lch-98/arm6_sim2real/docs/01_design.md

# 01. 설계 기록

무엇을 왜 그렇게 정했는지 남긴다. 숫자를 바꾸고 싶을 때 어떤 조건이 같이 바뀌는지 확인하는 용도다.

## 1. 목표와 제약

- 데스크톱 크기의 6축 관절형 팔 + 평행 그리퍼
- 구조 부품은 **전부 3D 프린팅**. 구매 부품은 액추에이터, 베어링, 그리퍼 피니언 기어뿐
- 통신은 CAN, ROS 2 Humble + ros2_control
- 시뮬레이션에서 먼저 검증한 뒤 실물을 단계별로 만들고, 실물 측정값을 시뮬레이션에 되돌려 넣는다 (Sim2Real)
- 외형은 기존 제품을 따르지 않고 독자적으로 디자인한다. 관절 배치(6축 수직다관절)는 업계 공통 구성이다

## 2. 관절 구성

| 관절 | 역할 | 축 | 범위 | 원점 오프셋 |
|---|---|---|---|---|
| joint1 | 베이스 회전 | z | ±170° | 바닥에서 66 mm |
| joint2 | 어깨 피치 | y | ±110° | J1에서 z 68 mm |
| joint3 | 팔꿈치 피치 | y | −150° ~ +32° | J2에서 z 170 mm (상완) |
| joint4 | 전완 롤 | x | ±170° | J3에서 x 115 mm |
| joint5 | 손목 피치 | y | ±110° | J4에서 x 100 mm (전완) |
| joint6 | 손목 롤 | x | ±170° | J5에서 x 95 mm |
| 그리퍼 | 평행 핑거 2개 | y | 핑거당 0 ~ 20 mm | J6에서 x 56 mm |

- **홈 자세** (전 관절 0): 상완 수직, 전완~그리퍼는 앞(+x)으로 수평
- **관절 한계를 정한 근거**: 각 관절을 하나씩 돌리며 자기간섭이 처음 생기는 각도를 계산하고 여유를 둠. 관절로 바로 이어진 두 링크끼리의 간섭은 `cad/check_clearance.py`로 따로 검사 ([02](02_cad_files.md))
  - J2: 142°에서 상완이 베이스에 닿음 → ±110°
  - J3: +38°에서 전완 J4 캔이 상완 빔에 닿음 → +32°
  - J5: ±119°에서 J6 캔이 손목 요크에 닿고, −130°에서 카메라 마운트가 link3에 닿음 → ±110°
- **수평 최대 도달 거리**: J1 축에서 TCP까지 0.566 m. 전체 질량 약 2.93 kg (카메라 포함)

### 관절 구조

- **피치 관절 (J2, J3, J5)**: 양쪽 지지 요크(클레비스). 한쪽 판 바깥에 액추에이터, 반대쪽 판에 지지 베어링
  - 액추에이터 출력 → 판 구멍을 지나는 **어댑터 원판** → 자식 링크 허브
  - 반대쪽: 베어링 내륜에 **핀**이 끼워져 허브까지 들어감
  - 조립 순서: 허브를 요크 사이에 넣기 → 어댑터 삽입·체결 → 액추에이터 장착 → 베어링 압입 → 핀 삽입 → 베어링 캡
- **롤 관절 (J4, J6), 그리퍼**: 링크 끝 원통 캔에 액추에이터를 앞에서 넣고 고정 링으로 누름. 다음 링크는 출력면에 원판으로 체결
- **J1**: 베이스 기둥 안에 액추에이터가 들어감
- **그리퍼**: 모터 1개 → 모듈 1·20T 피니언 → 위·아래 랙 2개(핑거와 일체 프린팅)가 반대 방향으로 이동. 최대 벌림 약 44 mm
  - 두 랙 모두 피니언 바로 위·아래(y = 0)에 이 사이가 오도록 위상을 맞춰, 닫힌 상태에서 두 핑거가 대칭
  - **안내 구조**: 랙은 가이드판(뒤)과 앞 덮개 사이에 끼워져 y 방향으로만 미끄러진다
    - 가이드판 바깥 벽: 랙이 피니언 반대쪽(z)으로 빠지지 않게 막음
    - 앞 덮개: 랙이 앞(x)으로 빠지지 않게 막음. 랙에서 나온 스템이 덮개 슬롯을 지나 앞의 연결판·패드와 이어짐
    - 위 슬롯은 +y 끝, 아래 슬롯은 −y 끝이 열려 있어, 덮개를 먼저 체결(M3 ×6)하고 핑거를 옆에서 밀어 넣는다
    - 공차: 랙 앞뒤·벽 0.3 mm(`CLR`), 스템↔슬롯 0.4 mm(`SLOT_CLR`). 시편으로 조정
    - 스트로크 0~20 mm 전 구간에서 피니언 회전을 포함해 간섭 없음 확인
    - 슬롯이 열린 쪽에는 기계적 끝 멈춤이 없다. 스트로크는 모터 위치 한계로 제한하고, 필요하면 슬롯 끝에 멈춤 볼트를 단다
  - 핑거 안쪽 TPU 패드: 미끄럼 방지(마찰↑)와 물체 형상에 맞춰 눌리는 완충. 끝쪽 V홈은 원통형 물체를 가운데로 모음

### 외형 디자인

| 부위 | 형태 |
|---|---|
| 상완 | 속이 빈 둥근 사각 빔 (내부 = 배선 통로) |
| 요크 | 관절 쪽으로 좁아지는 윤곽, 판과 브릿지가 하나로 이어진 U자 |
| 베이스 | 팔각 플랜지 + 원뿔대 기둥, 뒤쪽 케이블 출구 |
| 그리퍼 | 원통형 하우징 + 가로 가이드판, 핑거 안쪽 V홈 |
| 배색 | 본체 웜 화이트, 캡·패드 주황 |

## 3. 통신: 일반 CAN으로 충분한가

CAN 2.0A 8바이트 프레임 = 111비트, 비트 스터핑 최악 135비트 → 1 Mbps에서 프레임당 약 0.135 ms.
모터 7개 × (명령 + 응답) = 한 주기에 14프레임.

| 제어 주기 | 버스 부하 |
|---|---|
| 100 Hz | 19% |
| 200 Hz | 38% |
| 250 Hz | 47% |
| 500 Hz | 94% |

**결론**: 200~250 Hz 제어까지 여유가 있어 CAN FD가 필요 없다. 컨트롤러 주기는 200 Hz로 정했다.
일반 CAN이면 기존 USB-CAN 어댑터를 그대로 쓸 수 있고, 리눅스 커널 버전 제약도 없다.

## 4. 액추에이터 선정

Damiao 제품군으로 통일했다. 실제 구매는 **Seeed reBot Arm B601-DM Body Motor Kit**(4340P ×3, 4310 ×3, USB-CAN 보드, 전원 분리 보드, XT30(2+2) 케이블)에 그리퍼용 H3510 1개를 더한 구성이다. 모두 드라이버 일체형이고 기본 통신이 CAN 1 Mbps이며, 같은 프로토콜(MIT·위치·속도 모드)을 쓴다.

| 관절 | 모델 | 정격 / 피크 토크 | 외경 × 높이, 질량 | 판매처 표시가 (2026-10) |
|---|---|---|---|---|
| J1, J2, J3 | DM-J4340P-2EC | 9 (판매처에 따라 12) / 27 N·m (40:1) | 57 × 56.5 mm (출력 플랜지 약 Ø38 × 1.5), 약 375 g | 키트 |
| J4, J5, J6 | DM-J4310-2EC | 3 / 7 N·m (10:1) | 57 × 46 mm (출력 플랜지 Ø35 × 1.0), 약 300 g | 키트 |
| 그리퍼 | DM-H3510 | 0.18 / 0.45 N·m (직결) | 42 × 31.5 mm, 116 g | 약 $47 (별도) |

- 치수는 판매처 도면(디바이스마트 키트 페이지), 정격·질량은 Seeed의 DAMIAO 43 시리즈 자료값. 4340P 출력 플랜지 지름은 도면에 수치가 없어 도면 축척으로 잰 값이다
- 판매처마다 정격값 표기가 다른 경우 낮은 값을 썼다. 모터를 받으면 질량을 저울로 재고 출력 플랜지를 캘리퍼스로 재서 `ACT`를 바꾼다
- **검토했다가 뺀 구성**
  - CAN FD + 어깨 DM-J8009 (20 N·m): 팔을 크게 만들 때의 구성. 소형으로 줄이면서 불필요해졌고 비용이 큼
  - DM-S2325, DM-S3519 (더 저렴): 증분형 엔코더라 전원을 켤 때마다 원점 복귀가 필요하고, 형상이 길어 관절 옆으로 튀어나옴

## 5. 크기와 토크

처음에는 Dobot Magician(리치 320 mm)급으로 줄였다가, 링크 사이 공간(공구·배선)이 부족해 상완 170 mm, 전완 100 mm로 늘렸다. 이후 J6를 4310(Ø57)으로 바꾸면서 J6 캔이 손목 요크에 닿지 않도록 손목(L5)을 70 → 95 mm로 늘렸다.
늘리면서 J3(4310)의 토크 여유가 부족해져(0.2 kg에서 정격의 91%) **J3를 4340으로 바꿨다** (이후 키트 구성으로 J1~J3 모두 4340P).

팔을 수평으로 완전히 편 최악 자세의 정적 중력 토크 (카메라·마운트 포함):

| 가반하중 | J2 (정격 9 N·m) | J3 (정격 9 N·m) | J5 (정격 3 N·m) |
|---|---|---|---|
| 0 kg | 6.1 N·m (68%) | 3.0 N·m (34%) | 0.55 N·m (18%) |
| 0.3 kg | 7.8 N·m (87%) | 4.2 N·m (46%) | 1.1 N·m (36%) |
| 0.5 kg | 8.9 N·m (99%) | 5.0 N·m (55%) | 1.4 N·m (48%) |

→ **설계 가반하중 0.3 kg** (최악 자세 기준, 가속 여유 포함). 한계는 J2이며 정격 9 N·m 기준 정적 최대는 약 0.50 kg (4340P 정격이 12 N·m면 J2 사용률 약 65%).
손목 자세를 전부 훑었을 때 J6 최대 중력 토크는 0.048 N·m (4310 정격의 2%).

**질량 가정**: 프린팅 부품은 PLA 1240 kg/m³ × 실효 충진율 0.5, 액추에이터는 사양표 질량, 베어링·볼트·배선 미포함.
실측값은 단계 2(시편 무게), 단계 3(중력 토크 식별)에서 바꾼다.

## 6. 손목 카메라 (Intel RealSense D435)

- 그리퍼 바디 위 패드(M3 인서트 2개)에 브래킷을 체결하고, 카메라 외형(90 × 25 × 25 mm)을 받침과 클램프로 잡는다
  - 카메라의 삼각대 나사·뒷면 M3 위치는 공개 자료에서 간격을 확인하지 못해 외형으로 잡는 방식을 택함
- 위치: link6 기준 카메라 본체 중심 (x 20, z 54) mm, 아래로 25° 숙임
  - TCP는 광축에서 약 14° 아래, 그리퍼 앞 200 mm 지점은 약 13° 위 → 둘 다 RGB 화각(세로 ±21°) 안
- 한계: 카메라~TCP 약 85 mm로 D435 최소 깊이 거리(0.105 m)보다 가깝다. **집는 순간 핑거 주변은 깊이값이 없고 RGB만 보인다.** 인식은 10 cm 이상 떨어진 접근 단계에서 끝내는 구성을 가정
- TF: `camera_link`(본체 중심, RealSense 드라이버와 같은 이름), `camera_optical_nominal`(공칭 광학 프레임)

## 7. 수정 이력

| 날짜 | 내용 | 이유 |
|---|---|---|
| 2026-10-27 | 6축 + 그리퍼 개념 모델, URDF·RViz | 시작 |
| 2026-10-27 | 외형 차별화 (빔·요크·베이스·그리퍼·배색) | 기존 제품과 디테일이 겹치지 않도록 |
| 2026-10-28 | 액추에이터 치수 반영, 전 부품 프린팅 구조 | 실물 제작 기준으로 전환 |
| 2026-10-28 | CAN FD → 일반 CAN, 소형화, 저가 모터 | 대역폭 계산 결과 일반 CAN으로 충분, 비용 |
| 2026-10-28 | 링크 연장, J3 4310 → 4340 | 링크 사이 공간 부족, 연장 후 J3 토크 여유 부족 |
| 2026-10-29 | 손목 D435 마운트 추가 | 이후 비전 작업 대비 |
| 2026-11-04 | 요크를 한 윤곽 돌출 + 홈 방식으로 변경 | 사다리꼴 판과 직사각 브릿지가 만나는 곳에 최대 3.5 mm 단차가 있었음 |
| 2026-11-04 | ros2_control (mock, Gazebo), 기준 궤적, 기록·분석 도구 | 시뮬레이션 기준선 ([04](04_sim_baseline.md)) |
| 2026-11-10 | 모터 구성을 키트 기준으로 변경: J1~J3 4340P, J6 4310, 그리퍼만 H3510. 베이스 높이 58 → 66 mm | Seeed reBot Arm B601-DM Body Motor Kit(4340P ×3, 4310 ×3) 구매. 단품보다 저렴하고 USB-CAN·케이블 포함. 4340P가 더 높아 베이스를 올림 |
| 2026-11-11 | 손목 L5 70 → 95 mm, J3 상한 +60° → +32°, 그리퍼 랙 가이드판 분리, 분해도 STEP·이웃 링크 간섭 검사 추가 | J6 캔(4310)이 손목 요크판·J5 모터와 겹침(FreeCAD에서 발견). 이웃 링크끼리는 URDF 충돌 검사에서 빠져 있었고, 같은 검사로 J3 +38° 간섭도 찾음. 그리퍼 모터가 캔과 판 사이에 갇혀 조립할 수 없었음 |
| 2026-11-11 | 그리퍼 랙 안내 구조 추가: 가이드판 바깥 벽 + 앞 덮개(`rack_cover`) + 핑거 스템 | 핑거를 붙잡는 구조가 없어 랙이 앞·옆으로 빠질 수 있었음 |
| 2026-11-11 | 피니언을 인벌류트 치형으로 표시, 랙 위상 정렬, 핑거 캐리지를 피니언 앞으로 우회 | 피니언이 원기둥으로만 표시되어 물림을 확인할 수 없었음. 치형으로 바꾸자 핑거 캐리지가 피니언과 겹치는 것이 드러남 |
| 2026-11-11 | 액추에이터 출력 플랜지 치수(4340P 약 Ø38×1.5, 4310 Ø35×1.0)와 4340P 질량(362 → 375 g) 반영 | 판매처 도면·Seeed 자료와 대조. 이전에는 출력부를 외경의 0.3배 × 3 mm로 가정했음 |

## 8. 남은 과제

- **액추에이터 체결 구멍**: 하우징·출력 플랜지 볼트 패턴은 공식 도면(STEP)을 받은 뒤 반영 (단계 2). 그 전에는 출력하지 않는다
- 질량·관성은 프린팅 시편과 중력 토크 식별로 실측값으로 바꾼다
- **J1 베이스 베어링 보류** (2026-11-12): J1은 팔 전체가 넘어지려는 모멘트(0.3 kg에서 최대 약 7.8 N·m)를 모터 출력 베어링이 받는다. Damiao가 허용 모멘트를 공개하지 않아 일단 베어링 없이 조립하고, 흔들림·처짐이 보이면 베이스와 link1만 바꿔 61814급 베어링을 추가한다
