lch-98/arm6_sim2real/docs/README.md

# 문서 목차

처음부터 순서대로 읽으면 같은 팔을 만들 수 있도록 정리한 문서다.
각 문서는 **왜 그렇게 정했는지 → 어떻게 하는지 → 결과가 어떻게 나와야 하는지** 순서로 쓴다.

| 순서 | 문서 | 내용 | 상태 |
|---|---|---|---|
| 00 | [로드맵](00_roadmap.md) | 전체 단계 계획 (구매 순서, 단계별 측정 항목, 소모품·공구) | 계획 |
| 01 | [설계 기록](01_design.md) | 구조·통신·모터·치수를 정한 근거, 수정 이력 | 완료 |
| 02 | [CAD와 파일](02_cad_files.md) | 형상 생성 스크립트, STEP/STL 차이, 프린팅 파일 | 완료 |
| 03 | [개발 환경](03_dev_setup.md) | Ubuntu 22.04 + ROS 2 Humble + Gazebo 설치, 빌드 | 완료 |
| 04 | [시뮬레이션 기준선](04_sim_baseline.md) | ros2_control (mock, Gazebo), 기준 궤적, 기록·분석 | 완료 |
| 05 | [모터 단품 벤치](05_motor_bench.md) | 준비물, CAN 설정, 벤치 도구(`arm_hardware`), 모터 특성 측정, 1축 하드웨어 인터페이스 | 진행 중 |
| 06 | 체결 설계·프린팅 시편 | 볼트 패턴 반영, 공차·소재 확정 | 예정 |
| 07 | J1~J3 서브 어셈블리 | 조립, 영점, 중력 토크로 질량 식별 | 예정 |
| 08 | 손목·그리퍼 | 손목 조립, 그리퍼 보정 | 예정 |
| 09 | 전체 통합 | MoveIt 실기 구동, 안전 기능, 손목 카메라 | 예정 |
| 10 | Sim2Real 루프 | 식별값 반영, 시뮬레이션 랜덤화 | 예정 |

실험 결과(분석 요약, 그래프)는 [results/](results/)에 단계별로 모은다.

## 용어

| 용어 | 뜻 |
|---|---|
| 기준선 (baseline) | 실물과 비교하기 위해 시뮬레이션에서 먼저 만들어 두는 기록 |
| 기준 궤적 세트 | 모든 단계에서 똑같이 돌리는 동작 목록 (`reference_trajectories.yaml`) |
| mock 하드웨어 | 명령을 그대로 상태로 돌려주는 가짜 하드웨어. 동역학이 없음 |
| 유지 토크 | 그 자세에서 팔이 처지지 않게 모터가 내야 하는 토크 |
| TCP | Tool Center Point. 그리퍼 끝에서 10 mm 안쪽 기준점 |
