lch-98/arm6_sim2real/arm_description/cad/arm_assembly.step

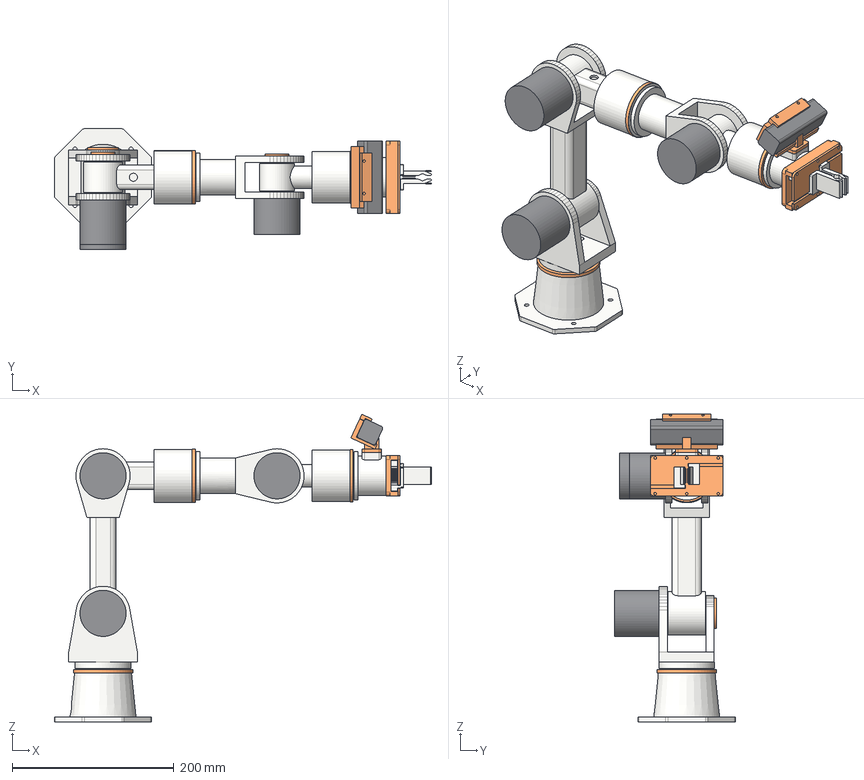
[picture p3: CAD file, 2026-11-11]
arm_description/cad/arm_assembly.step
466.0 x 149.0 x 380.1 mm
base_link__body
base_link__base_band
base_link__motor
link1__body
link1__j2_bearing_cap
link1__motor
link1__bearing
link2__body
link2__j2_adapter
link2__j2_pin
link2__j3_bearing_cap
link2__motor
link2__bearing
link3__body
link3__j3_adapter
link3__j3_pin
link3__j4_retainer_ring
link3__motor
link4__body
link4__j5_bearing_cap
link4__motor
link4__bearing
link5__body
link5__j5_adapter
link5__j5_pin
link5__j6_retainer_ring
link5__motor
link6__body
link6__rack_guide
link6__rack_cover
link6__pinion_m1_20t
link6__motor
finger_left__body
finger_left__pad
finger_right__body
finger_right__pad
camera__camera_mount
camera__camera_d435
