lch-98/arm6_sim2real/arm_description/cad/step/link3__j3_adapter.step

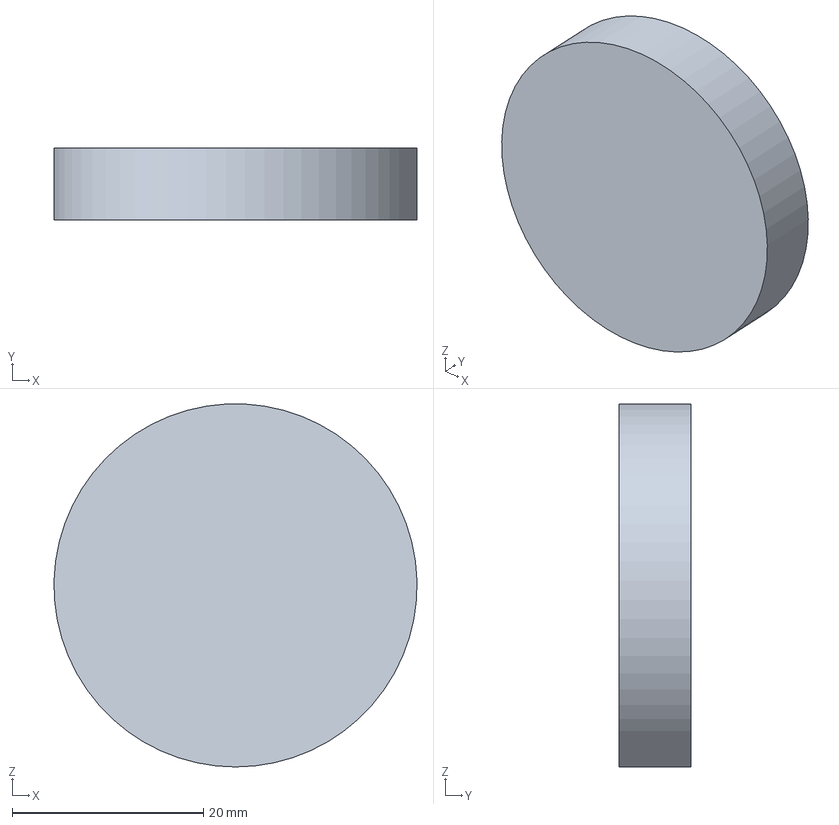
[picture p4: CAD file, 2026-11-11]
arm_description/cad/step/link3__j3_adapter.step
38.0 x 7.50 x 38.0 mm
