lch-98/arm6_sim2real/arm_description/meshes/link4_body.stl

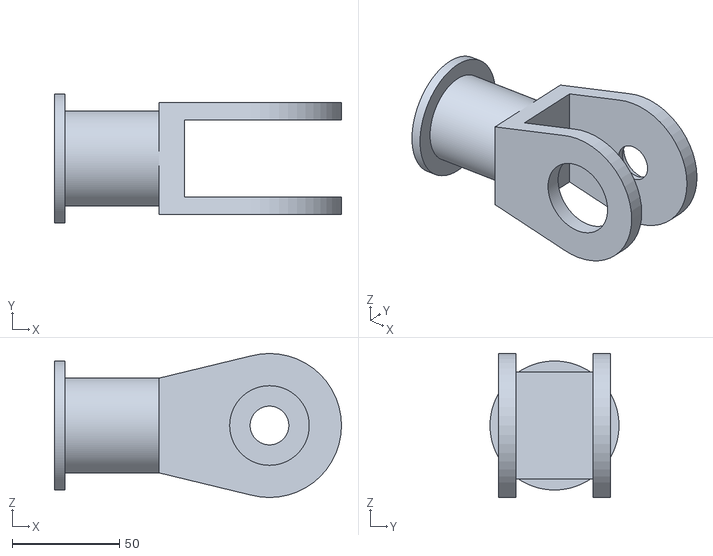
[picture p5: CAD file, 2026-11-11]
arm_description/meshes/link4_body.stl
133.5 x 60.0 x 67.0
