lch-98/arm6_sim2real/arm_description/print/finger_right__pad_TPU.stl

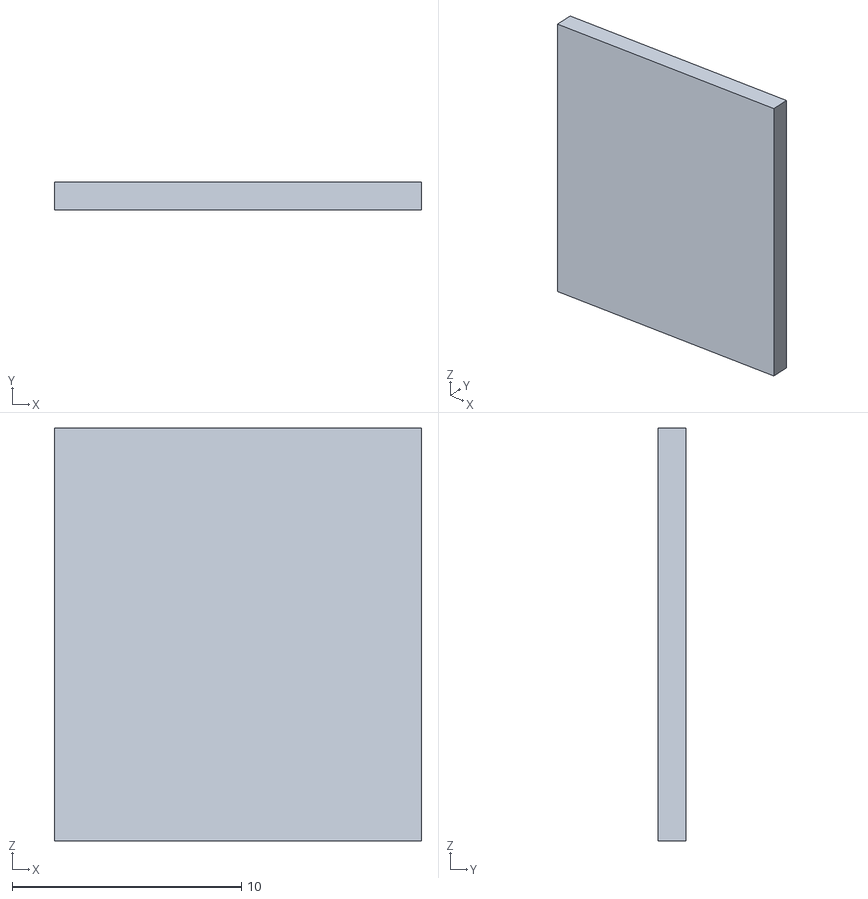
[picture p6: CAD file, 2026-11-04]
arm_description/print/finger_right__pad_TPU.stl
16.0 x 1.20 x 18.0
