lch-98/arm6_sim2real/arm_description/cad/step/link4__j5_bearing_cap.step

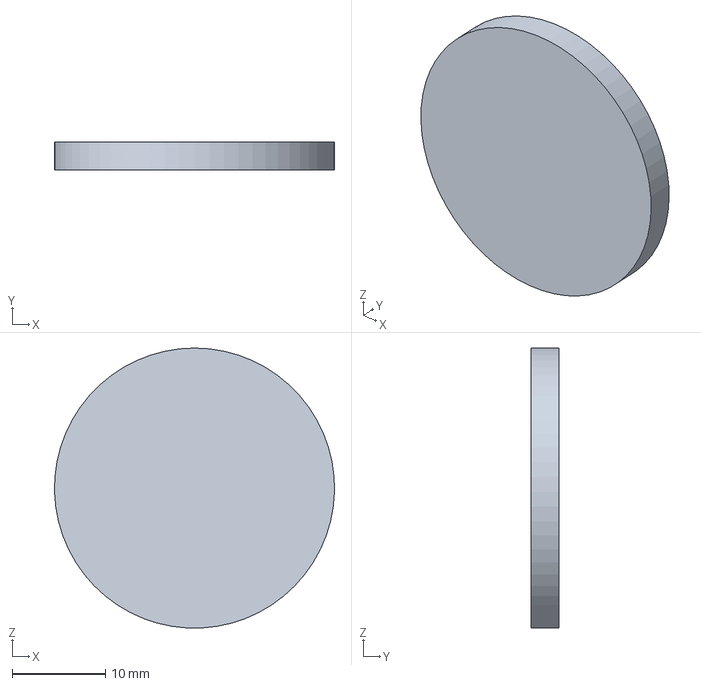
[picture p8: CAD file, 2026-11-11]
arm_description/cad/step/link4__j5_bearing_cap.step
30.0 x 3.00 x 30.0 mm
