lch-98/arm6_sim2real/arm_description/meshes/link2_body.stl

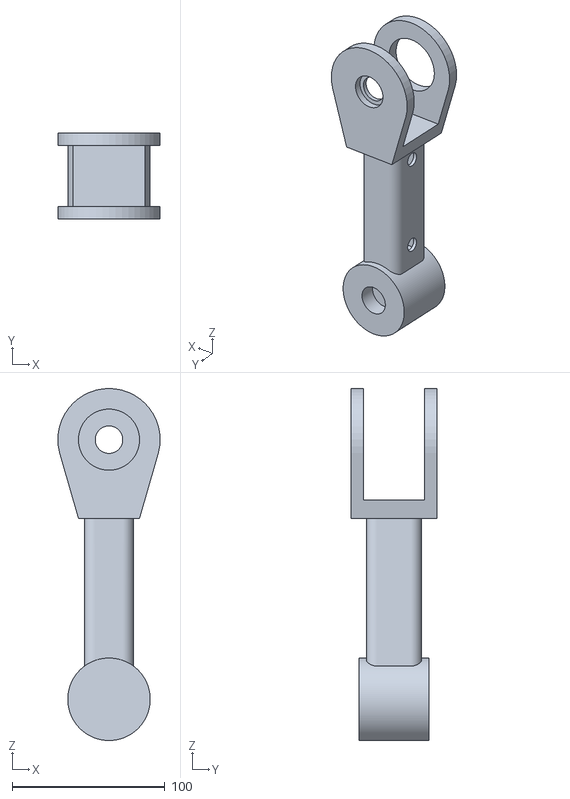
[picture p9: CAD file, 2026-11-11]
arm_description/meshes/link2_body.stl
67.0 x 56.0 x 230.5
