lch-98/arm6_sim2real/arm_description/cad/step/link1.step

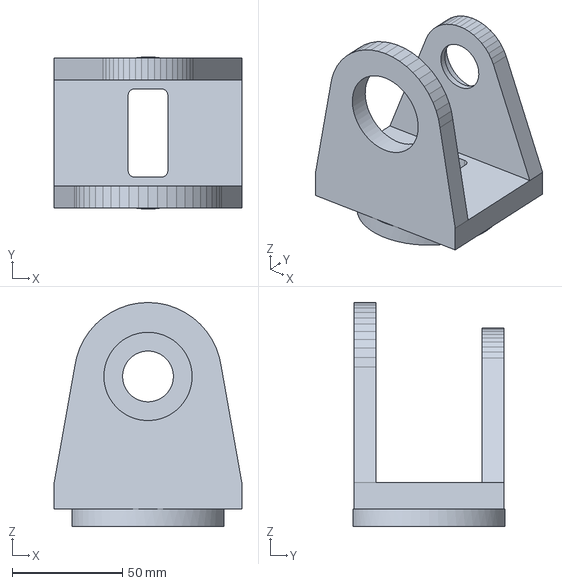
[picture p10: CAD file, 2026-11-11]
arm_description/cad/step/link1.step
85.0 x 69.0 x 101.5 mm
