lch-98/arm6_sim2real/arm_description/meshes/link4_motor.stl

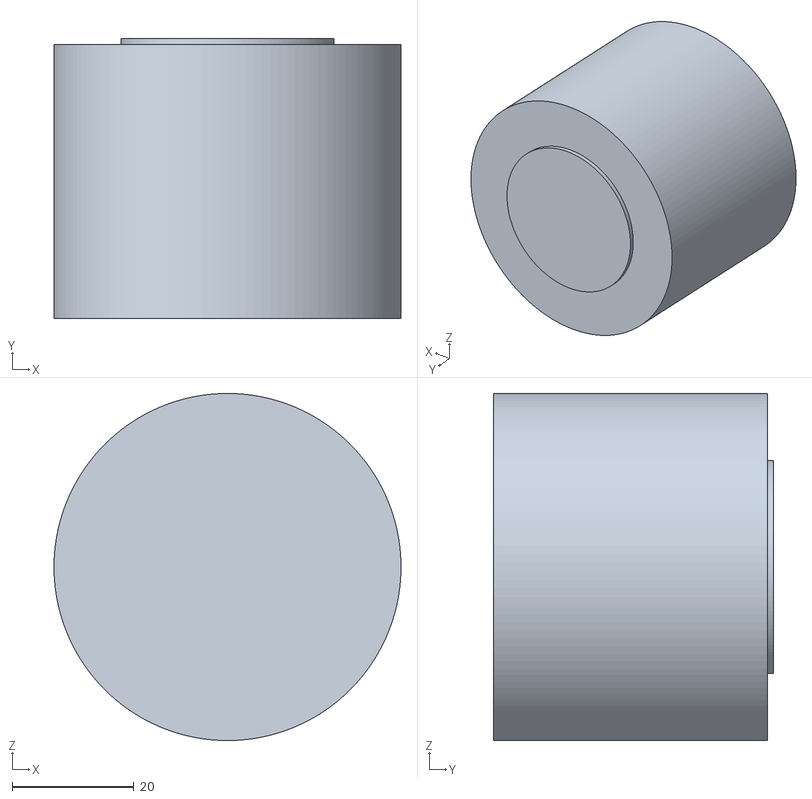
[picture p11: CAD file, 2026-11-11]
arm_description/meshes/link4_motor.stl
57.0 x 46.0 x 57.0
