lch-98/arm6_sim2real/arm_description/cad/step/camera__clamp.step

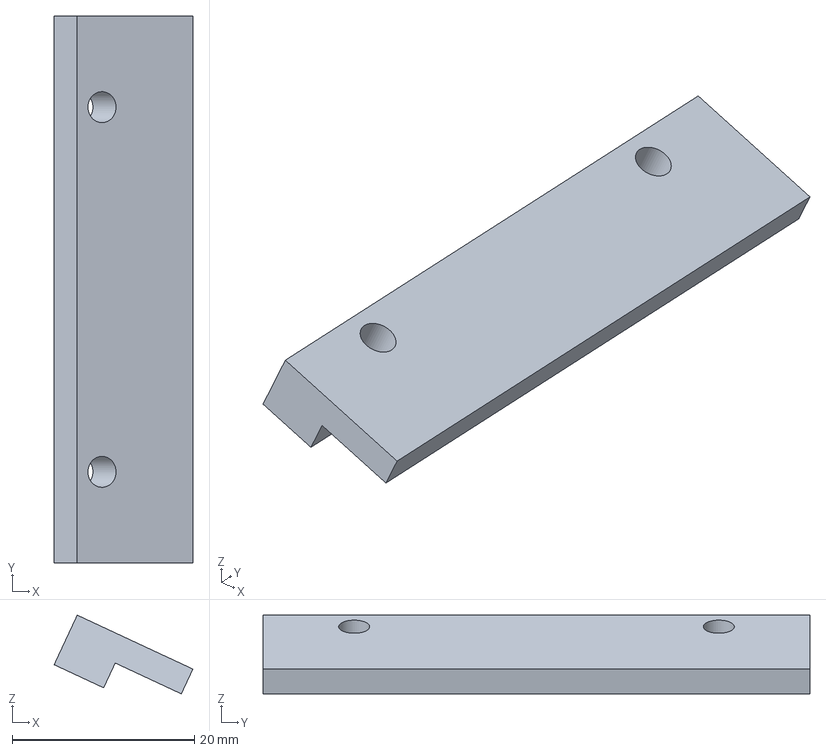
[picture p12: CAD file, 2026-11-11]
arm_description/cad/step/camera__clamp.step
15.2 x 60.0 x 8.64 mm
