lch-98/arm6_sim2real/arm_description/meshes/link5_body.stl

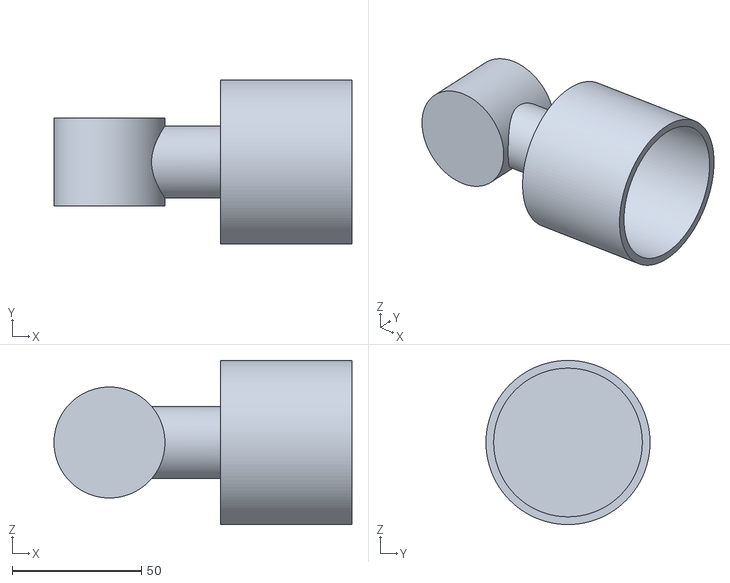
[picture p13: CAD file, 2026-11-11]
arm_description/meshes/link5_body.stl
115.5 x 63.6 x 63.6
