lch-98/arm6_sim2real/arm_description/meshes/base_link_collision.stl

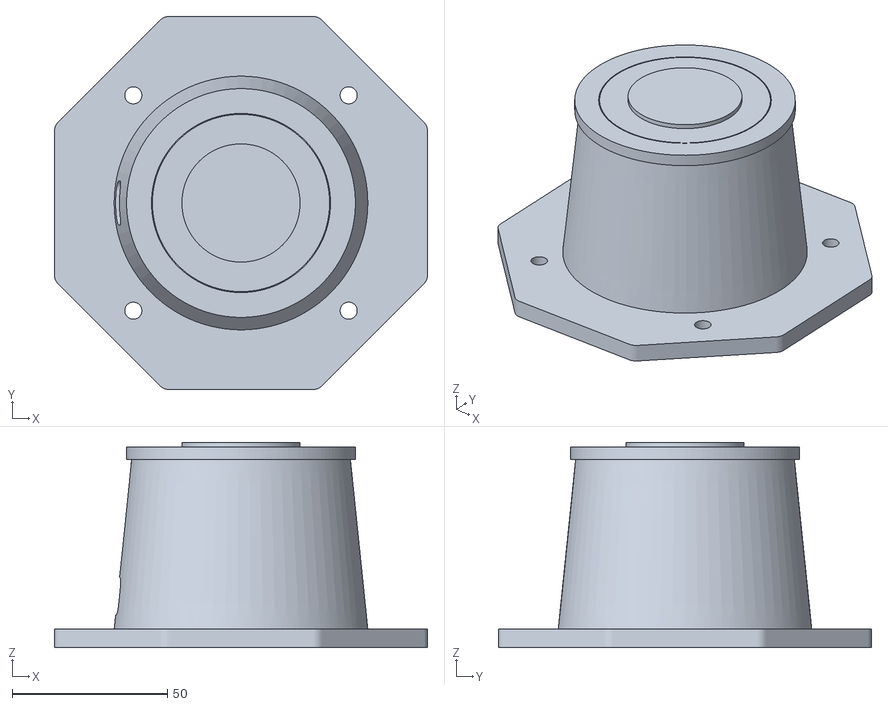
[picture p14: CAD file, 2026-11-11]
arm_description/meshes/base_link_collision.stl
120.0 x 120.0 x 66.0
