lch-98/arm6_sim2real/arm_description/cad/step/link3__j4_retainer_ring.step

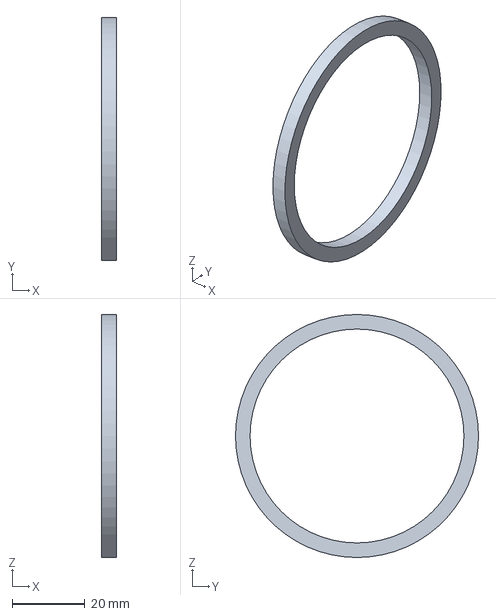
[picture p15: CAD file, 2026-11-11]
arm_description/cad/step/link3__j4_retainer_ring.step
4.00 x 66.6 x 66.6 mm
