lch-98/arm6_sim2real/arm_description/meshes/link3_body.stl

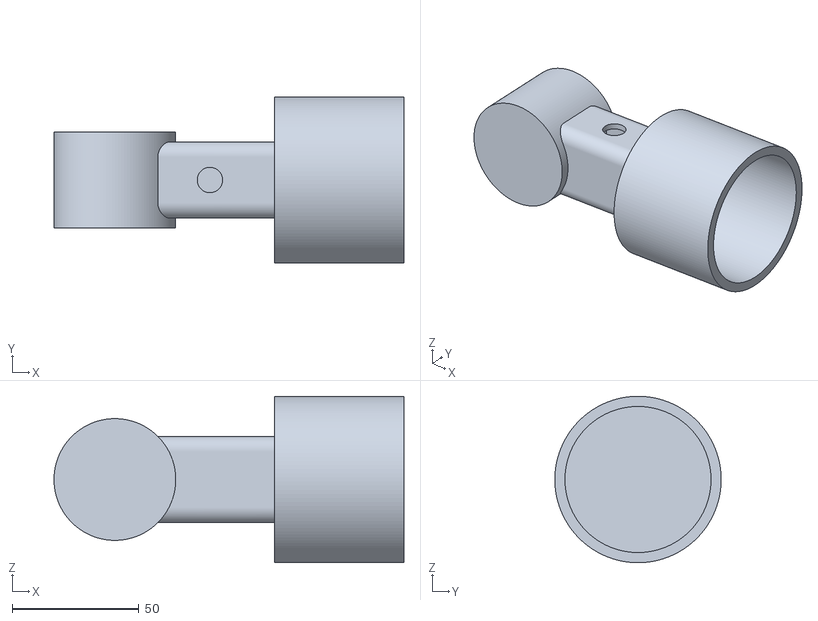
[picture p16: CAD file, 2026-11-11]
arm_description/meshes/link3_body.stl
138.0 x 65.6 x 65.6
