lch-98/arm6_sim2real/arm_description/meshes/base_link_motor.stl

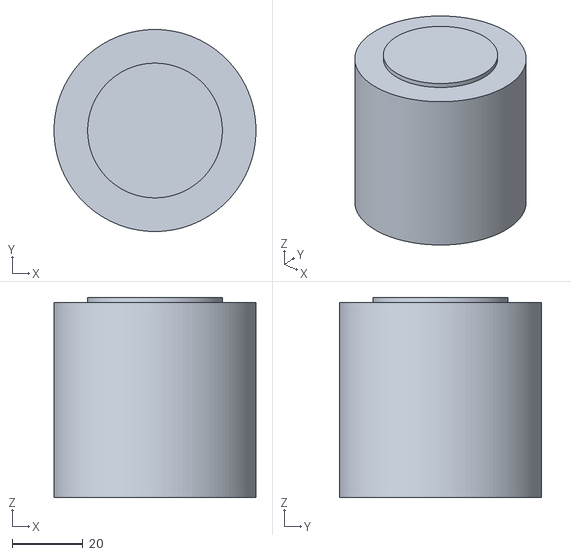
[picture p17: CAD file, 2026-11-11]
arm_description/meshes/base_link_motor.stl
57.0 x 57.0 x 56.5
