lch-98/arm6_sim2real/arm_description/cad/step/link5__j6_retainer_ring.step

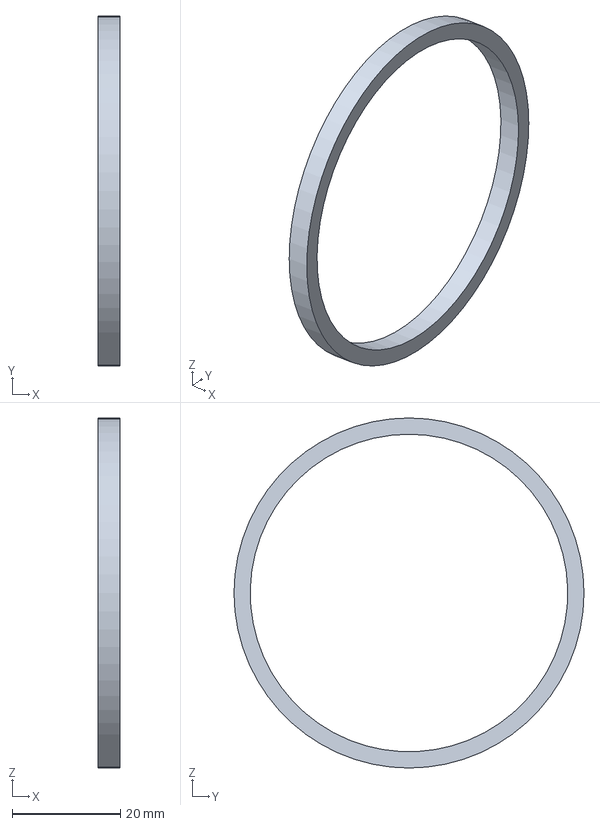
[picture p18: CAD file, 2026-11-11]
arm_description/cad/step/link5__j6_retainer_ring.step
4.00 x 64.6 x 64.6 mm
