lch-98/arm6_sim2real/arm_description/meshes/link2_accent.stl

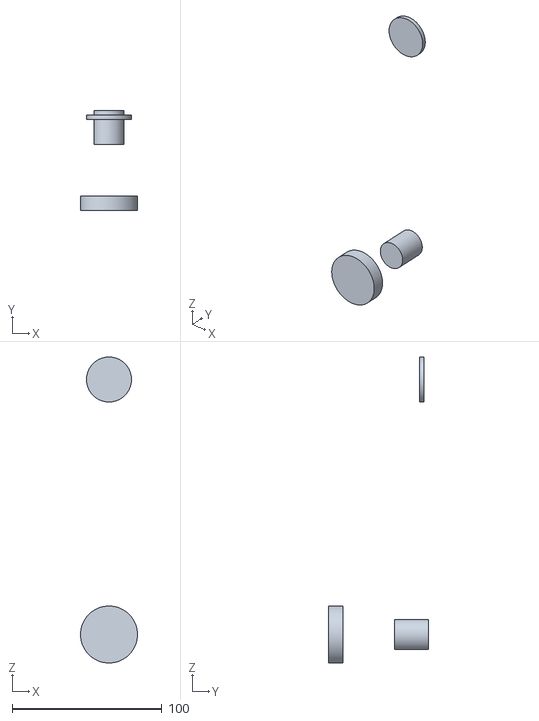
[picture p19: CAD file, 2026-11-11]
arm_description/meshes/link2_accent.stl
38.0 x 66.5 x 204.0
