lch-98/arm6_sim2real/arm_description/cad/step/link5__j5_adapter.step

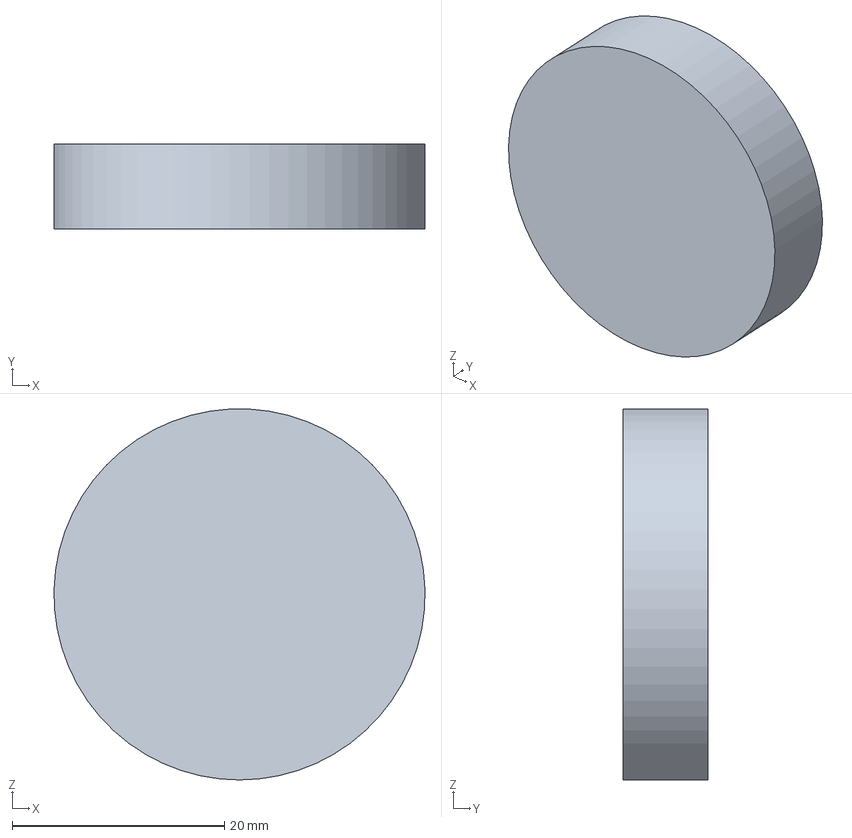
[picture p20: CAD file, 2026-11-11]
arm_description/cad/step/link5__j5_adapter.step
35.0 x 8.00 x 35.0 mm
