lch-98/arm6_sim2real/arm_description/meshes/link4_collision.stl

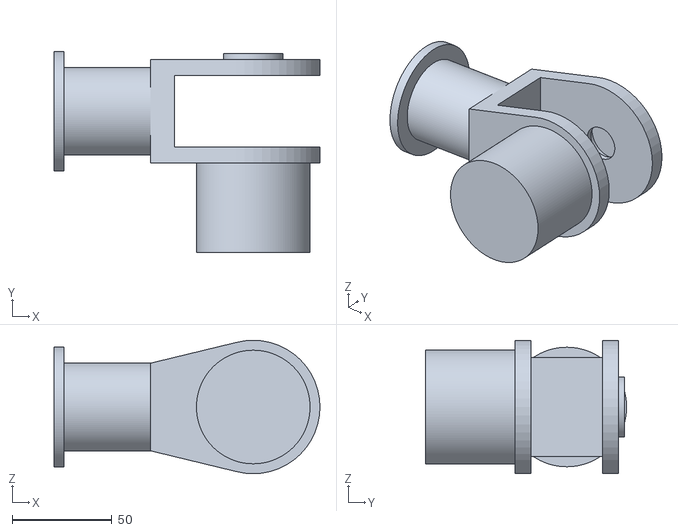
[picture p21: CAD file, 2026-11-11]
arm_description/meshes/link4_collision.stl
133.5 x 101.0 x 67.0
