lch-98/arm6_sim2real/arm_description/cad/step/finger_left.step

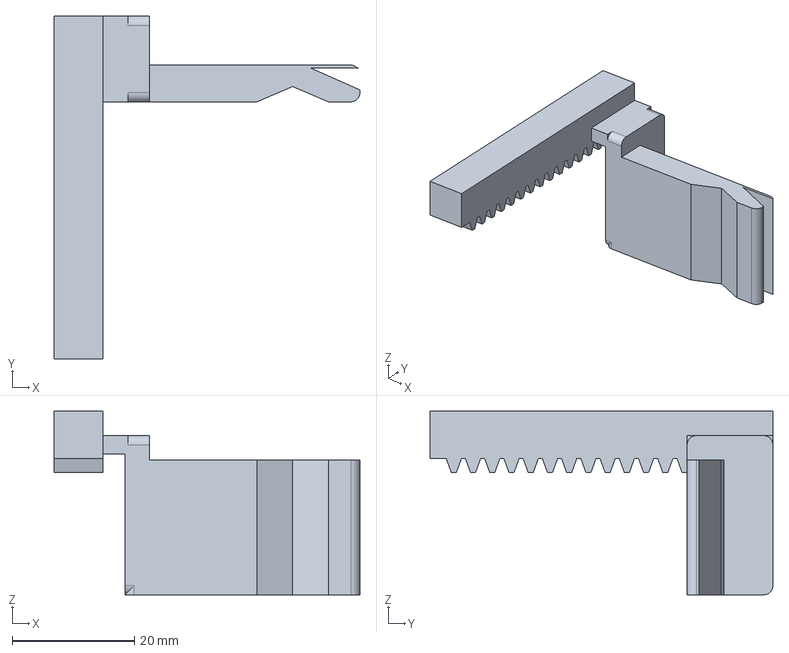
[picture p22: CAD file, 2026-11-11]
arm_description/cad/step/finger_left.step
50.0 x 56.0 x 30.0 mm
