lch-98/arm6_sim2real/arm_description/meshes/link5_accent.stl

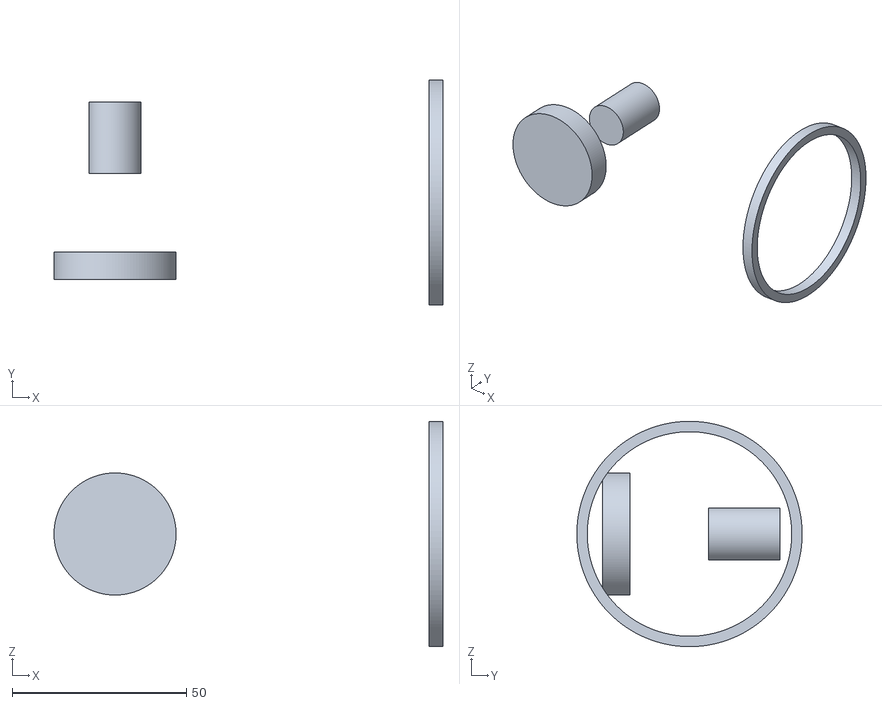
[picture p23: CAD file, 2026-11-11]
arm_description/meshes/link5_accent.stl
111.5 x 64.6 x 64.6
