lch-98/arm6_sim2real/arm_description/meshes/link6_body.stl

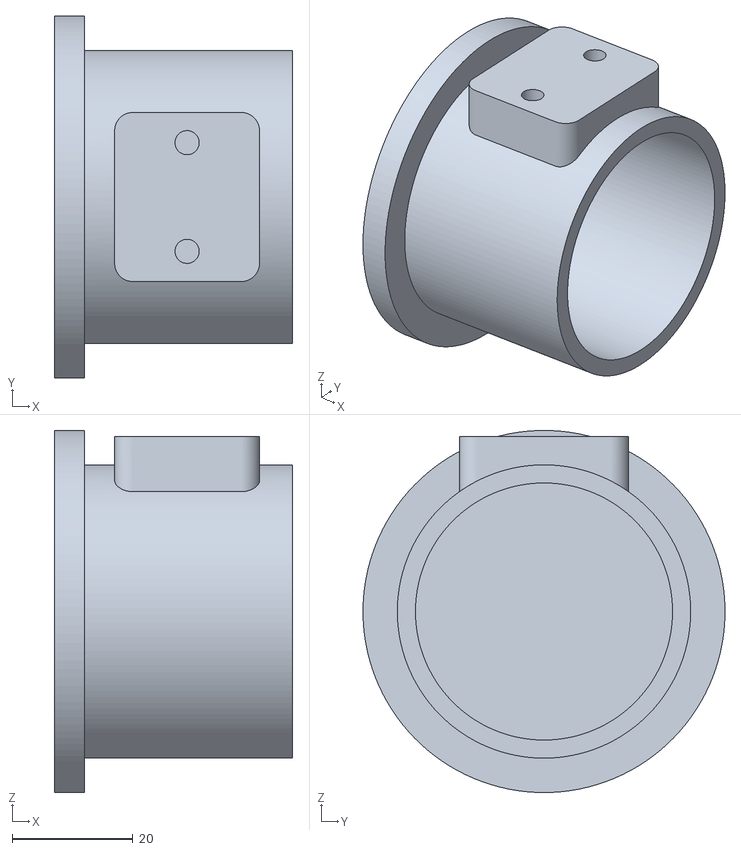
[picture p24: CAD file, 2026-11-11]
arm_description/meshes/link6_body.stl
39.5 x 60.0 x 60.0
