lch-98/arm6_sim2real/arm_description/cad/step/link2__j2_adapter.step

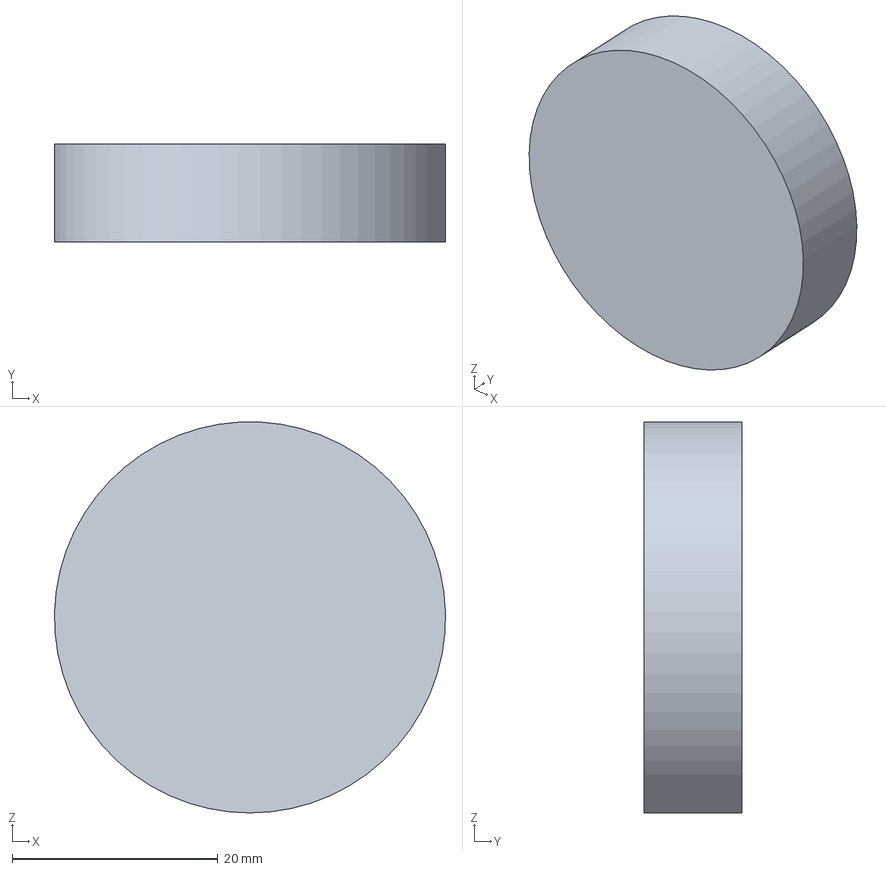
[picture p25: CAD file, 2026-11-11]
arm_description/cad/step/link2__j2_adapter.step
38.0 x 9.50 x 38.0 mm
