lch-98/arm6_sim2real/arm_description/cad/step/base_link__base_band.step

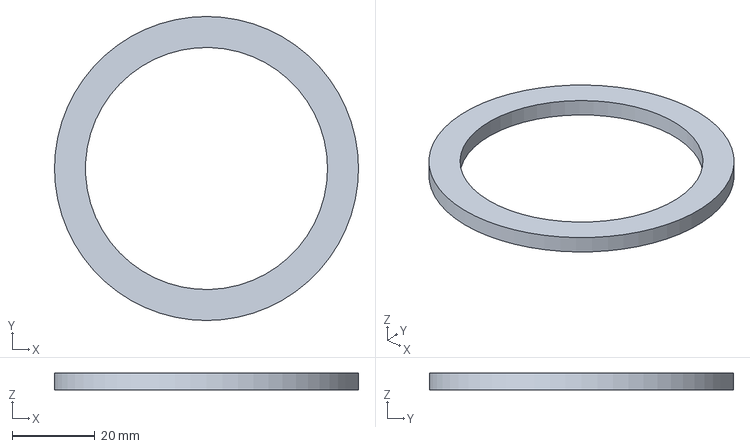
[picture p26: CAD file, 2026-11-11]
arm_description/cad/step/base_link__base_band.step
73.6 x 73.6 x 4.00 mm
