lch-98/arm6_sim2real/arm_description/meshes/link3_collision.stl

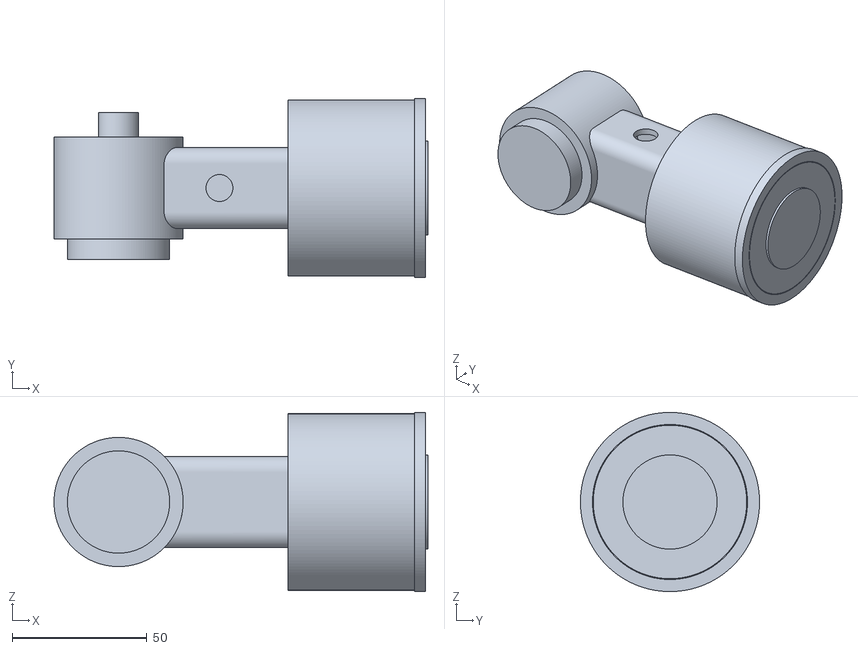
[picture p27: CAD file, 2026-11-11]
arm_description/meshes/link3_collision.stl
139.0 x 66.6 x 66.6
