lch-98/arm6_sim2real/arm_description/cad/step/link6__rack_guide.step

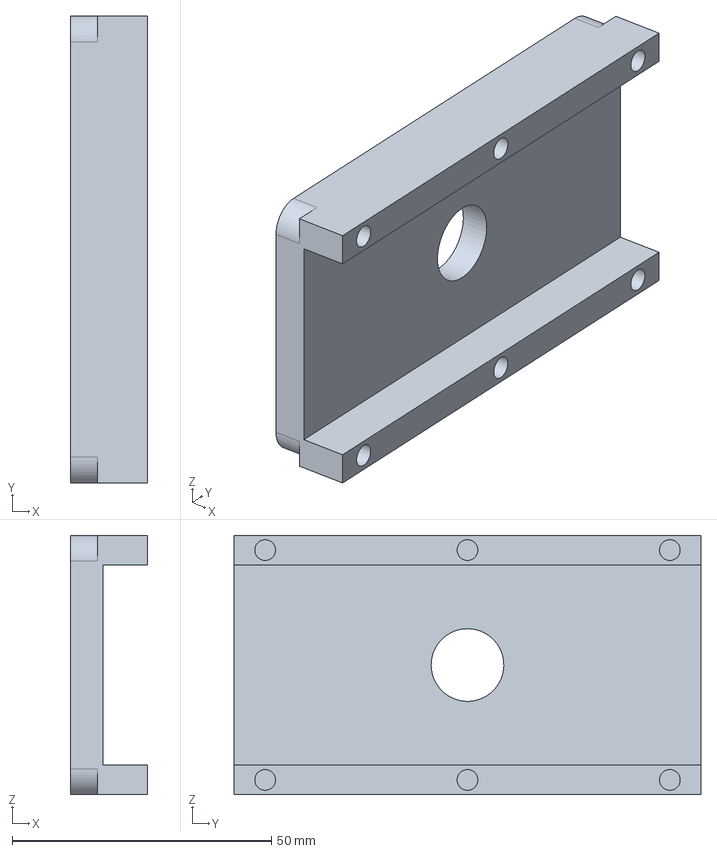
[picture p28: CAD file, 2026-11-11]
arm_description/cad/step/link6__rack_guide.step
14.8 x 90.0 x 50.0 mm
