lch-98/arm6_sim2real/arm_description/cad/step/link6__rack_cover.step

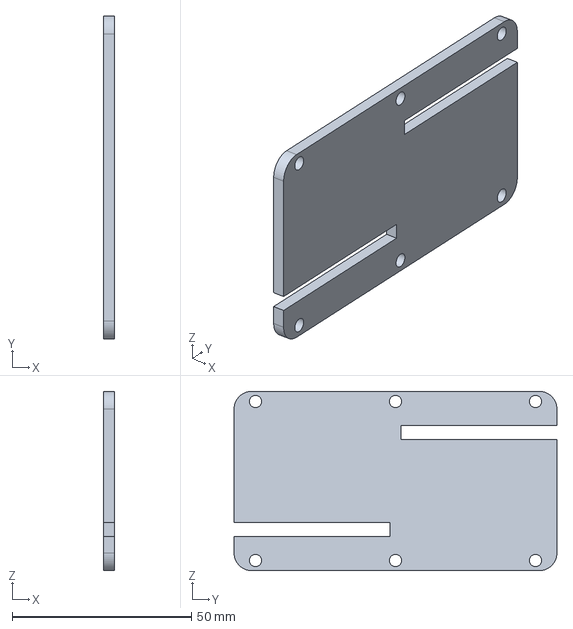
[picture p29: CAD file, 2026-11-11]
arm_description/cad/step/link6__rack_cover.step
3.00 x 90.0 x 50.0 mm
