lch-98/arm6_sim2real/arm_description/meshes/link6_collision.stl

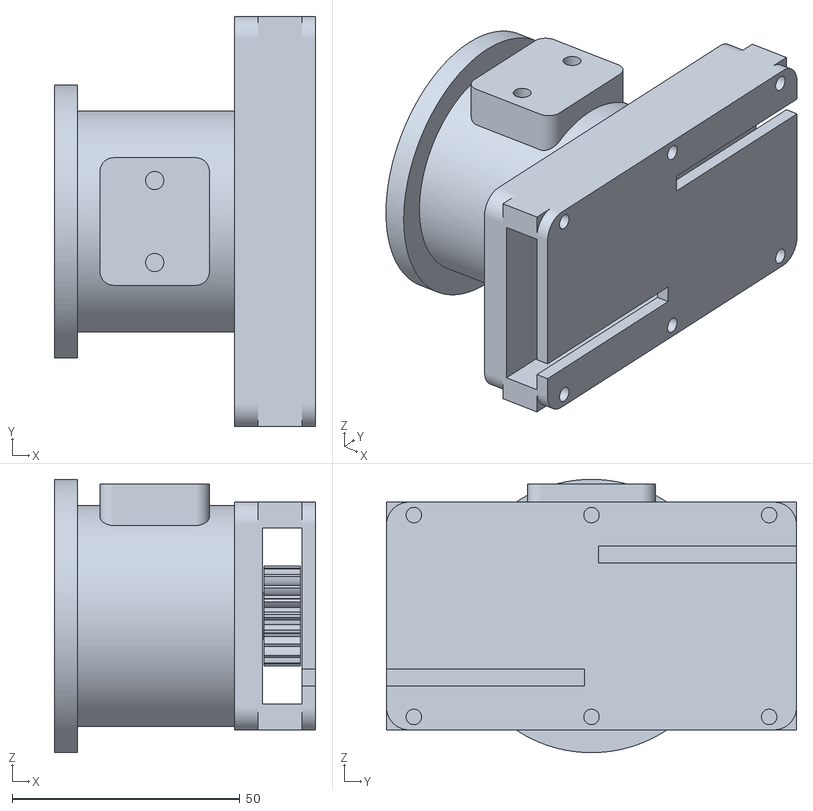
[picture p30: CAD file, 2026-11-11]
arm_description/meshes/link6_collision.stl
57.3 x 90.0 x 60.0
