lch-98/arm6_sim2real/arm_description/cad/step/link5__j5_pin.step

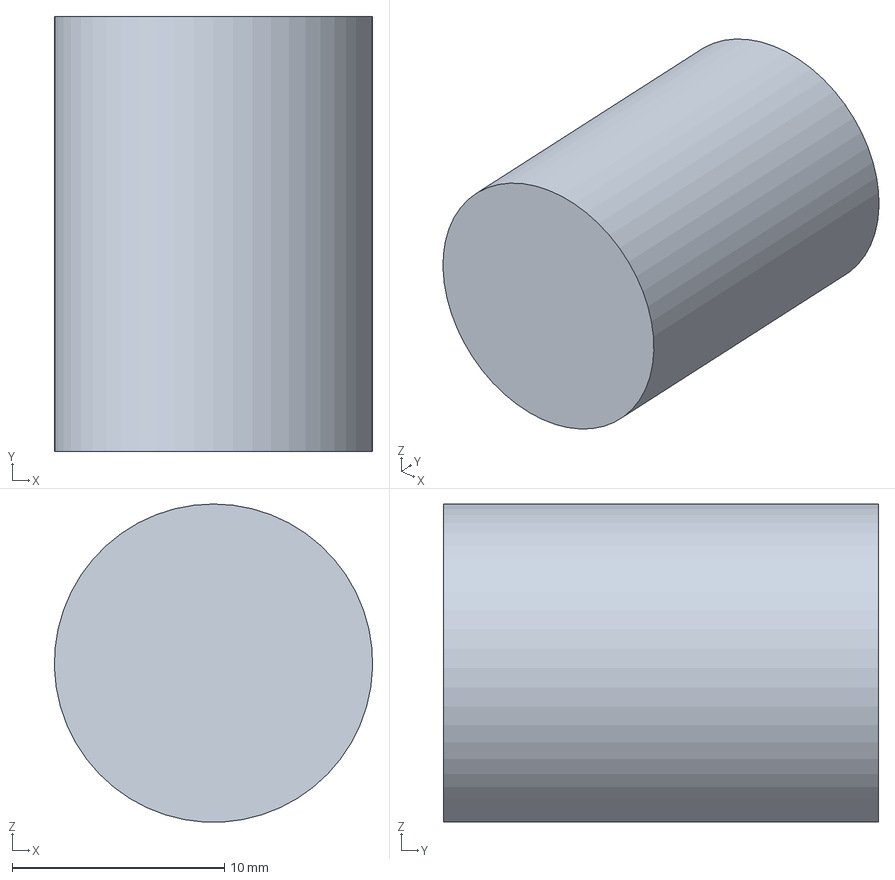
[picture p31: CAD file, 2026-11-11]
arm_description/cad/step/link5__j5_pin.step
15.0 x 20.5 x 15.0 mm
