lch-98/arm6_sim2real/arm_description/cad/step/base_link.step

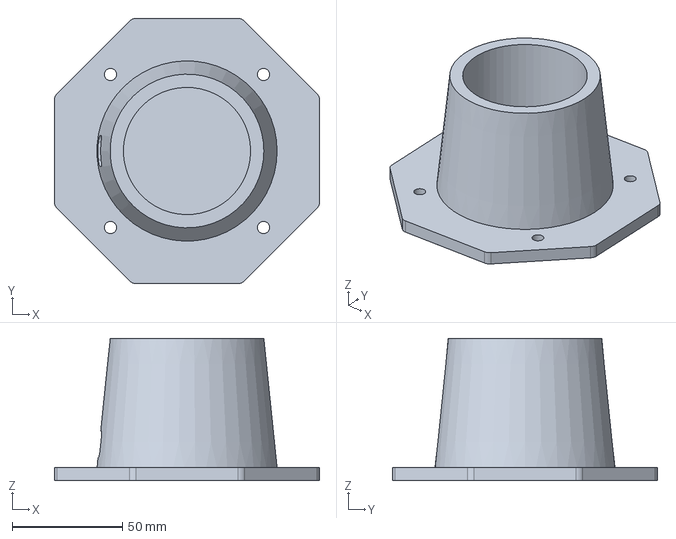
[picture p32: CAD file, 2026-11-11]
arm_description/cad/step/base_link.step
120.0 x 120.0 x 64.5 mm
