lch-98/arm6_sim2real/arm_description/meshes/link1_collision.stl

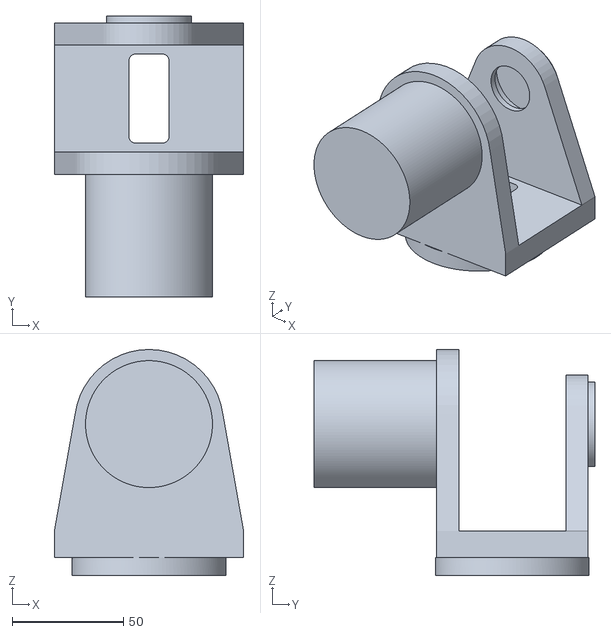
[picture p33: CAD file, 2026-11-11]
arm_description/meshes/link1_collision.stl
85.0 x 126.0 x 101.5
