lch-98/arm6_sim2real/arm_description/cad/step/link1__j2_bearing_cap.step

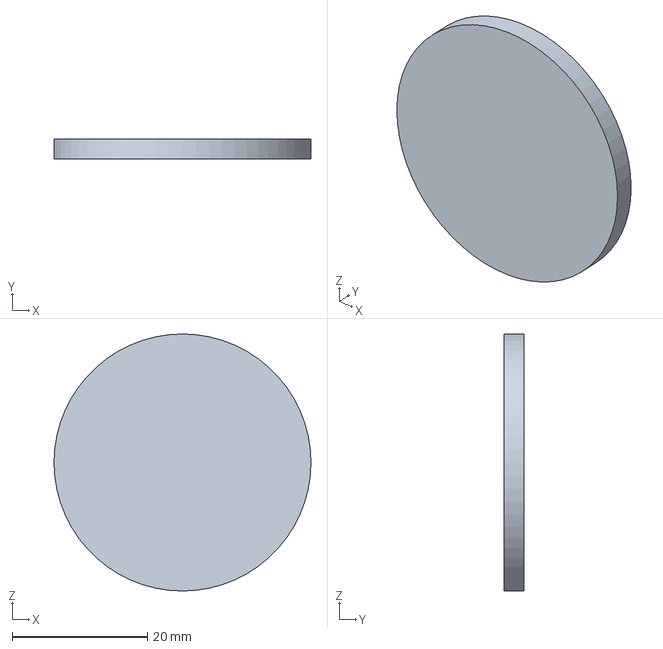
[picture p34: CAD file, 2026-11-11]
arm_description/cad/step/link1__j2_bearing_cap.step
38.0 x 3.00 x 38.0 mm
