lch-98/arm6_sim2real/arm_description/meshes/link5_collision.stl

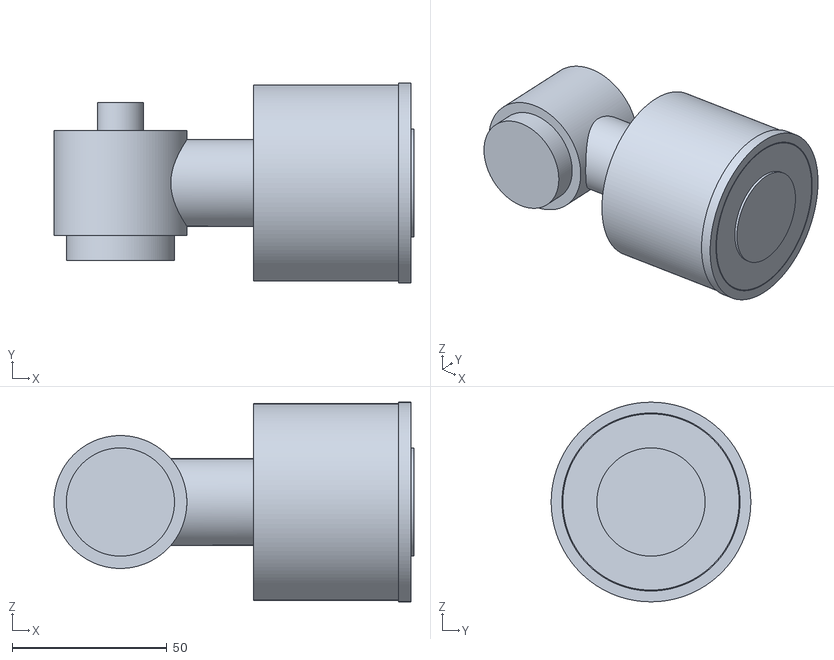
[picture p35: CAD file, 2026-11-11]
arm_description/meshes/link5_collision.stl
116.5 x 64.6 x 64.6
