lch-98/arm6_sim2real/arm_description/cad/step/link2__j2_pin.step

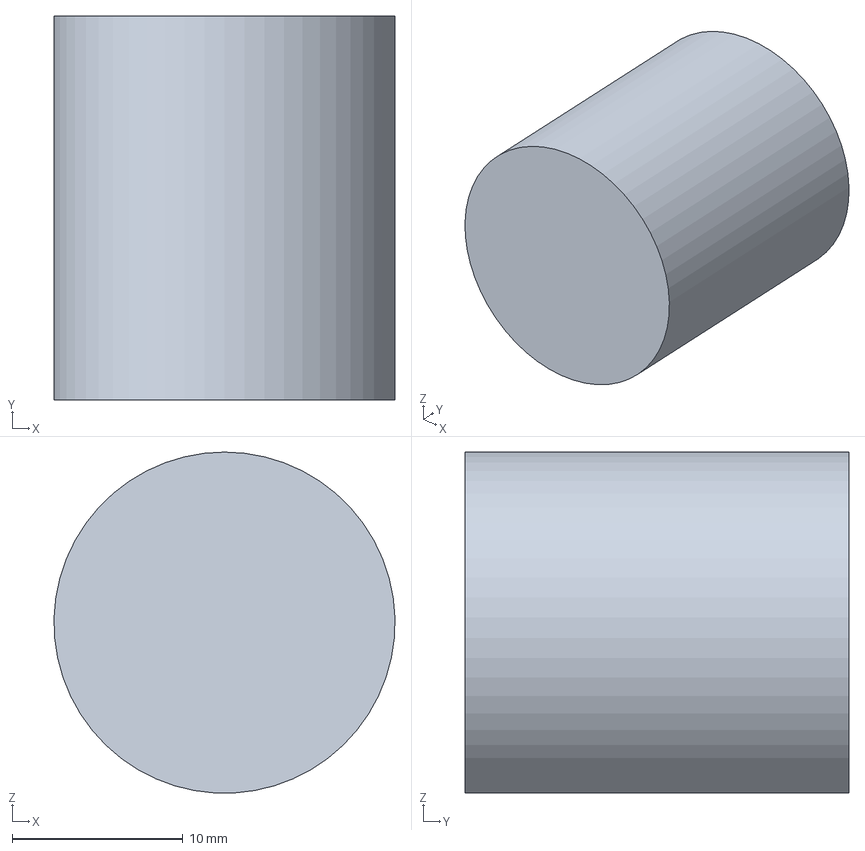
[picture p36: CAD file, 2026-11-11]
arm_description/cad/step/link2__j2_pin.step
20.0 x 22.5 x 20.0 mm
