lch-98/arm6_sim2real/arm_description/cad/step/camera__bracket.step

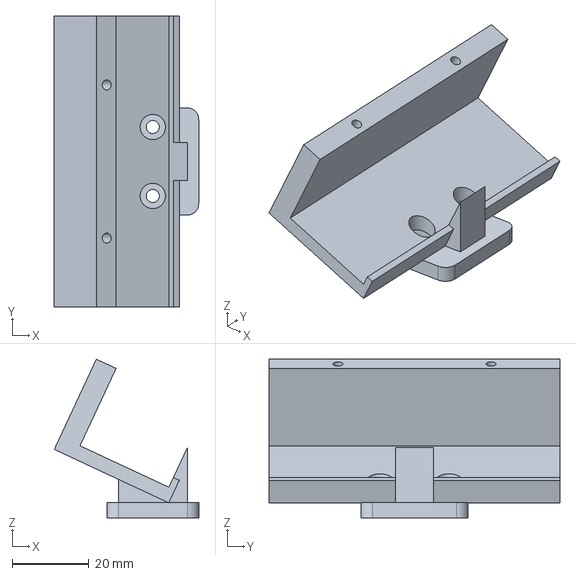
[picture p37: CAD file, 2026-11-11]
arm_description/cad/step/camera__bracket.step
37.7 x 76.0 x 41.4 mm
