lch-98/arm6_sim2real/arm_description/meshes/link6_accent.stl

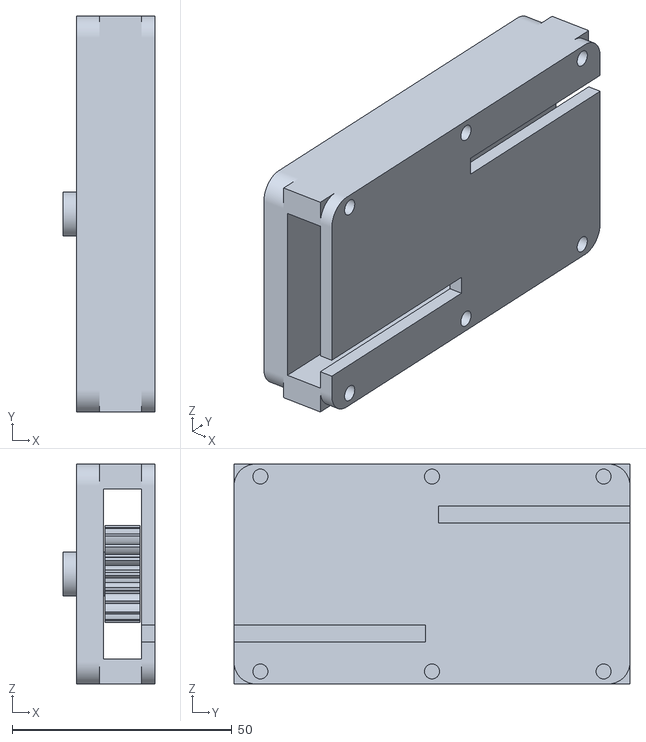
[picture p39: CAD file, 2026-11-11]
arm_description/meshes/link6_accent.stl
20.8 x 90.0 x 50.0
