lch-98/arm6_sim2real/arm_description/meshes/link2_collision.stl

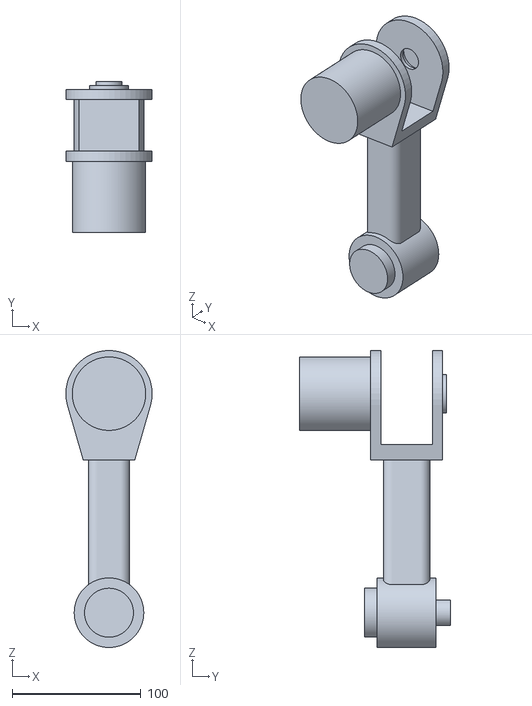
[picture p40: CAD file, 2026-11-11]
arm_description/meshes/link2_collision.stl
67.0 x 117.0 x 230.5
