lch-98/arm6_sim2real/arm_description/meshes/camera_mount_body.stl

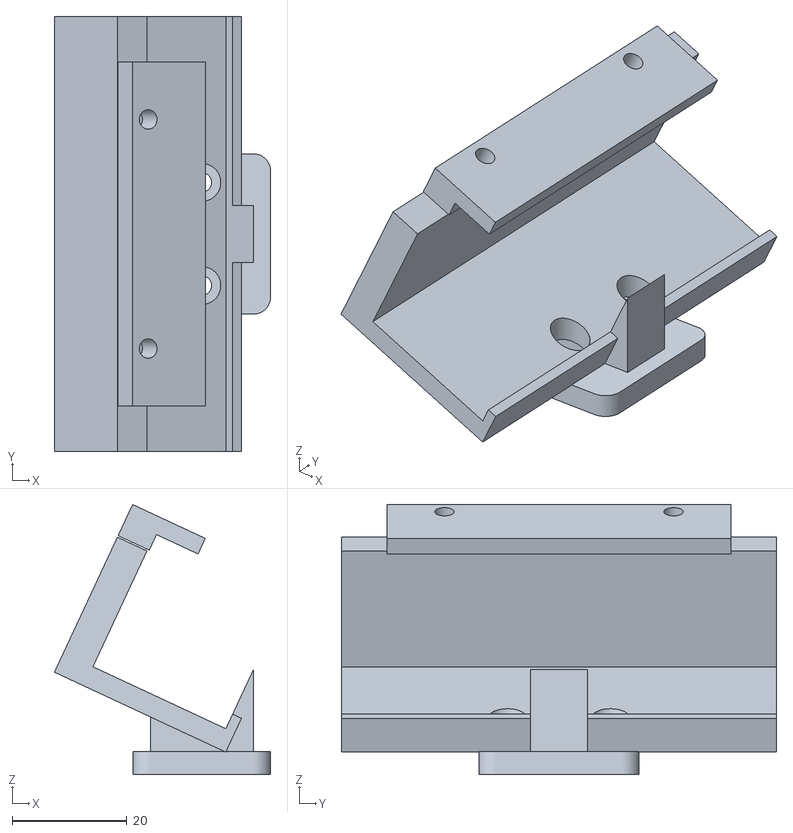
[picture p41: CAD file, 2026-11-04]
arm_description/meshes/camera_mount_body.stl
37.7 x 76.0 x 47.1
