lch-98/arm6_sim2real/arm_description/meshes/link6_motor.stl

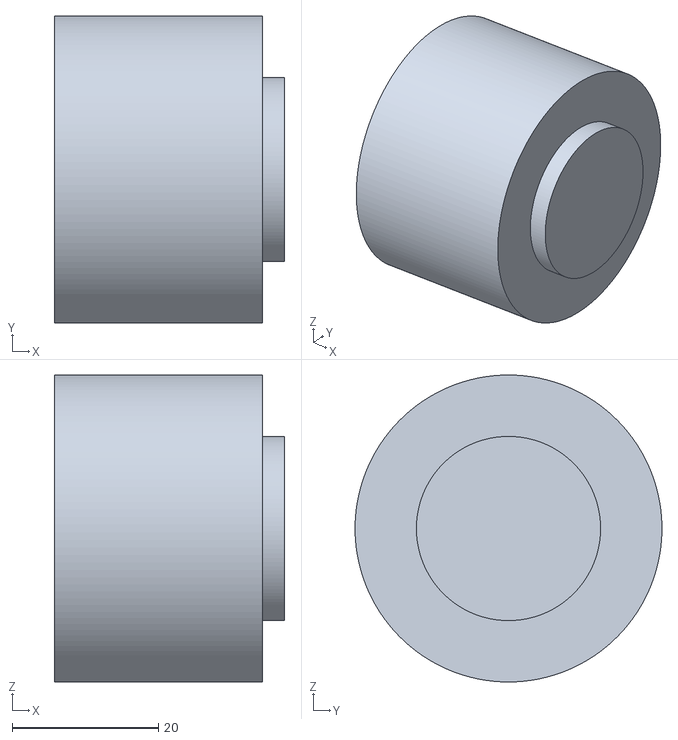
[picture p42: CAD file, 2026-11-04]
arm_description/meshes/link6_motor.stl
31.5 x 42.0 x 42.0
