lch-98/arm6_sim2real/arm_description/meshes/camera_d435_body.stl

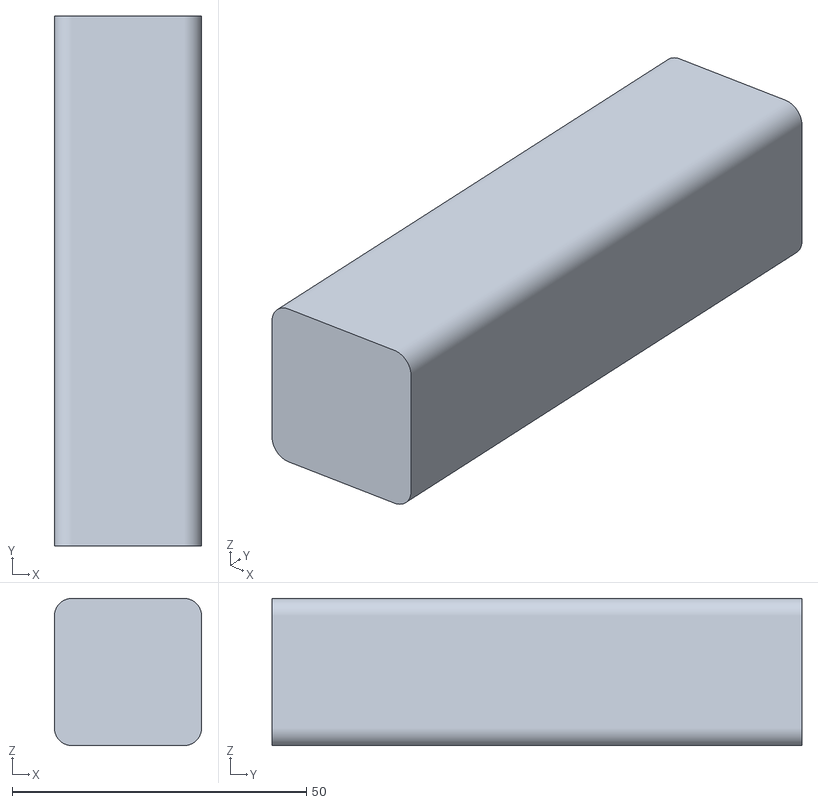
[picture p43: CAD file, 2026-11-04]
arm_description/meshes/camera_d435_body.stl
25.0 x 90.0 x 25.0
