lch-98/arm6_sim2real/(list of files, cad)

Other CAD files:
arm_description/print/finger_left__pad_TPU.stl
arm_description/cad/step/link2.step
arm_description/cad/step/finger_right__pad.step
arm_description/cad/step/link5.step
arm_description/cad/step/finger_right.step
arm_description/meshes/finger_left_body.stl
arm_description/meshes/link2_motor.stl
arm_description/meshes/link1_motor.stl
arm_description/cad/step/link4.step
arm_description/meshes/link1_body.stl
arm_description/cad/step/link3.step
arm_description/meshes/link3_motor.stl
arm_description/cad/step/link6.step
arm_description/meshes/link5_motor.stl
arm_description/cad/step/link2__j3_bearing_cap.step
arm_description/meshes/base_link_accent.stl
arm_description/meshes/finger_right_body.stl
arm_description/meshes/finger_right_collision.stl
arm_description/cad/step/link3__j3_pin.step
arm_description/cad/step/finger_left__pad.step
arm_description/meshes/base_link_body.stl
arm_description/meshes/finger_left_collision.stl
arm_description/meshes/link4_accent.stl
arm_description/meshes/finger_left_accent.stl
arm_description/meshes/link1_accent.stl
arm_description/print/base_link.stl
arm_description/print/base_link__base_band.stl
arm_description/print/camera__bracket.stl
arm_description/print/camera__clamp.stl
arm_description/print/finger_left.stl
arm_description/print/finger_right.stl
arm_description/print/link1.stl
arm_description/print/link1__j2_bearing_cap.stl
arm_description/print/link2__j2_adapter.stl
arm_description/print/link2__j2_pin.stl
arm_description/print/link2__j3_bearing_cap.stl
arm_description/print/link3__j3_adapter.stl
arm_description/print/link3__j3_pin.stl
arm_description/print/link3__j4_retainer_ring.stl
arm_description/print/link4__j5_bearing_cap.stl
arm_description/print/link5__j5_adapter.stl
arm_description/print/link5__j5_pin.stl
arm_description/print/link5__j6_retainer_ring.stl
arm_description/print/link6__rack_cover.stl
arm_description/print/link6__rack_guide.stl
