lch-98/arm6_sim2real/docs/results/00_sim_baseline/gazebo_summary.md

# 기준선 분석: `gazebo_baseline`

- 기록 길이 207.3 s, /joint_states 41453개 (평균 200 Hz)
- 비교 대상: `mock_baseline`

## 1. 구간별 추종 오차 (목표 − 실제) [mrad]

mock은 컨트롤러 보간 오차만, Gazebo는 시뮬레이터 위치 루프(position_proportional_gain)의 지연까지 포함한다.
실물 모터의 추종 오차와 직접 같지 않으며, 실물 단계에서 같은 표를 만들어 비교한다.

| 구간 | joint1 RMS / 최대 | joint2 RMS / 최대 | joint3 RMS / 최대 | joint4 RMS / 최대 | joint5 RMS / 최대 | joint6 RMS / 최대 |
|---|---|---|---|---|---|---|
| home | 0.0 / 0.0 | 0.0 / 0.0 | 0.0 / 0.0 | 0.0 / 0.0 | 0.0 / 0.0 | 0.0 / 0.0 |
| sweep/joint1 | 25.6 / 41.8 | 0.0 / 0.0 | 0.0 / 0.0 | 0.0 / 0.0 | 0.0 / 0.1 | 0.0 / 0.0 |
| sweep/joint2 | 0.0 / 0.0 | 13.4 / 22.0 | 0.0 / 0.0 | 0.0 / 0.0 | 0.0 / 0.0 | 0.0 / 0.0 |
| sweep/joint3 | 0.0 / 0.0 | 0.0 / 0.0 | 17.3 / 28.2 | 0.0 / 0.0 | 0.0 / 0.0 | 0.0 / 0.0 |
| sweep/joint4 | 0.0 / 0.0 | 0.0 / 0.0 | 0.0 / 0.0 | 47.9 / 78.3 | 0.0 / 0.0 | 0.0 / 0.0 |
| sweep/joint5 | 0.0 / 0.0 | 0.0 / 0.0 | 0.0 / 0.0 | 0.0 / 0.0 | 28.7 / 47.0 | 0.0 / 0.0 |
| sweep/joint6 | 0.0 / 0.0 | 0.0 / 0.0 | 0.0 / 0.0 | 0.0 / 0.0 | 0.0 / 0.0 | 57.4 / 94.0 |
| pick | 6.0 / 23.7 | 5.0 / 16.9 | 8.5 / 21.8 | 0.0 / 0.0 | 10.7 / 32.0 | 0.0 / 0.0 |
| home | 0.0 / 0.0 | 4.0 / 6.2 | 6.0 / 9.4 | 0.0 / 0.0 | 15.9 / 25.0 | 0.0 / 0.0 |

## 2. 정지 자세 토크 [N·m]

측정 = 기록된 effort (hold 마지막 구간 평균), 모델 = URDF 질량·무게중심으로 계산한 유지 토크.
mock 하드웨어는 effort를 계산하지 않으므로 측정값이 0 또는 nan으로 나온다.

| 자세 | q2, q3, q5 [rad] | J2 측정 / 모델 | J3 측정 / 모델 | J5 측정 / 모델 |
|---|---|---|---|---|
| static/00 | -0.50, -1.20, -0.60 | +2.213 / +2.215 | +0.721 / +0.722 | +0.404 / +0.404 |
| static/01 | -0.50, -1.20, +0.80 | +1.504 / +1.505 | +0.012 / +0.012 | -0.305 / -0.306 |
| static/02 | -0.50, -0.60, +0.00 | +0.167 / +0.167 | -1.325 / -1.326 | -0.207 / -0.208 |
| static/03 | -0.50, +0.50, -0.60 | -1.400 / -1.402 | -2.892 / -2.895 | -0.428 / -0.429 |
| static/04 | -0.50, +0.50, +0.80 | -1.391 / -1.393 | -2.883 / -2.886 | -0.419 / -0.420 |
| static/05 | +0.00, -1.20, +0.00 | -1.048 / -1.049 | -1.048 / -1.049 | -0.155 / -0.155 |
| static/06 | +0.00, +0.00, +0.00 | -3.016 / -3.019 | -3.016 / -3.019 | -0.552 / -0.553 |
| static/07 | +0.40, -0.20, +0.80 | -3.965 / -3.969 | -2.754 / -2.756 | -0.339 / -0.339 |
| static/08 | +0.80, -1.20, -0.60 | -4.759 / -4.764 | -2.527 / -2.529 | -0.258 / -0.258 |
| static/09 | +0.80, -1.20, +0.80 | -5.029 / -5.034 | -2.797 / -2.799 | -0.527 / -0.528 |
| static/10 | +0.80, -0.60, +0.00 | -5.197 / -5.203 | -2.965 / -2.968 | -0.551 / -0.551 |
| static/11 | +0.80, +0.00, -0.60 | -4.499 / -4.504 | -2.267 / -2.270 | -0.551 / -0.551 |

측정 − 모델: 평균 +0.002 N·m, RMS 0.002 N·m, 최대 0.005 N·m

## 3. 비교 기록의 추종 오차 RMS [mrad]

| 구간 | joint1 | joint2 | joint3 | joint4 | joint5 | joint6 |
|---|---|---|---|---|---|---|
| home | 0.0 | 0.0 | 0.0 | 0.0 | 0.0 | 0.0 |
| sweep/joint1 | 2.6 | 0.0 | 0.0 | 0.0 | 0.0 | 0.0 |
| sweep/joint2 | 0.0 | 1.4 | 0.0 | 0.0 | 0.0 | 0.0 |
| sweep/joint3 | 0.0 | 0.0 | 1.7 | 0.0 | 0.0 | 0.0 |
| sweep/joint4 | 0.0 | 0.0 | 0.0 | 4.8 | 0.0 | 0.0 |
| sweep/joint5 | 0.0 | 0.0 | 0.0 | 0.0 | 2.9 | 0.0 |
| sweep/joint6 | 0.0 | 0.0 | 0.0 | 0.0 | 0.0 | 5.8 |
| pick | 0.6 | 0.5 | 0.8 | 0.0 | 1.1 | 0.0 |
| home | 0.0 | 0.4 | 0.6 | 0.0 | 1.6 | 0.0 |
