lch-98/arm6_sim2real/docs/results/00_sim_baseline/mock_summary.md

# 기준선 분석: `mock_baseline`

- 기록 길이 212.0 s, /joint_states 42402개 (평균 200 Hz)

## 1. 구간별 추종 오차 (목표 − 실제) [mrad]

mock은 컨트롤러 보간 오차만, Gazebo는 시뮬레이터 위치 루프(position_proportional_gain)의 지연까지 포함한다.
실물 모터의 추종 오차와 직접 같지 않으며, 실물 단계에서 같은 표를 만들어 비교한다.

| 구간 | joint1 RMS / 최대 | joint2 RMS / 최대 | joint3 RMS / 최대 | joint4 RMS / 최대 | joint5 RMS / 최대 | joint6 RMS / 최대 |
|---|---|---|---|---|---|---|
| home | 0.0 / 0.0 | 0.0 / 0.0 | 0.0 / 0.0 | 0.0 / 0.0 | 0.0 / 0.0 | 0.0 / 0.0 |
| sweep/joint1 | 2.6 / 4.4 | 0.0 / 0.0 | 0.0 / 0.0 | 0.0 / 0.0 | 0.0 / 0.0 | 0.0 / 0.0 |
| sweep/joint2 | 0.0 / 0.0 | 1.4 / 2.3 | 0.0 / 0.0 | 0.0 / 0.0 | 0.0 / 0.0 | 0.0 / 0.0 |
| sweep/joint3 | 0.0 / 0.0 | 0.0 / 0.0 | 1.7 / 3.0 | 0.0 / 0.0 | 0.0 / 0.0 | 0.0 / 0.0 |
| sweep/joint4 | 0.0 / 0.0 | 0.0 / 0.0 | 0.0 / 0.0 | 4.8 / 8.3 | 0.0 / 0.0 | 0.0 / 0.0 |
| sweep/joint5 | 0.0 / 0.0 | 0.0 / 0.0 | 0.0 / 0.0 | 0.0 / 0.0 | 2.9 / 5.0 | 0.0 / 0.0 |
| sweep/joint6 | 0.0 / 0.0 | 0.0 / 0.0 | 0.0 / 0.0 | 0.0 / 0.0 | 0.0 / 0.0 | 5.8 / 10.0 |
| pick | 0.6 / 2.4 | 0.5 / 1.8 | 0.8 / 2.3 | 0.0 / 0.0 | 1.1 / 3.3 | 0.0 / 0.0 |
| home | 0.0 / 0.0 | 0.4 / 0.7 | 0.6 / 1.0 | 0.0 / 0.0 | 1.6 / 2.6 | 0.0 / 0.0 |

## 2. 정지 자세 토크 [N·m]

측정 = 기록된 effort (hold 마지막 구간 평균), 모델 = URDF 질량·무게중심으로 계산한 유지 토크.
mock 하드웨어는 effort를 계산하지 않으므로 측정값이 0 또는 nan으로 나온다.

| 자세 | q2, q3, q5 [rad] | J2 측정 / 모델 | J3 측정 / 모델 | J5 측정 / 모델 |
|---|---|---|---|---|
| static/00 | -0.50, -1.20, -0.60 | +0.000 / +2.215 | +0.000 / +0.722 | +0.000 / +0.404 |
| static/01 | -0.50, -1.20, +0.80 | +0.000 / +1.505 | +0.000 / +0.012 | +0.000 / -0.306 |
| static/02 | -0.50, -0.60, +0.00 | +0.000 / +0.167 | +0.000 / -1.326 | +0.000 / -0.208 |
| static/03 | -0.50, +0.50, -0.60 | +0.000 / -1.402 | +0.000 / -2.895 | +0.000 / -0.429 |
| static/04 | -0.50, +0.50, +0.80 | +0.000 / -1.393 | +0.000 / -2.886 | +0.000 / -0.420 |
| static/05 | +0.00, -1.20, +0.00 | +0.000 / -1.049 | +0.000 / -1.049 | +0.000 / -0.155 |
| static/06 | +0.00, +0.00, +0.00 | +0.000 / -3.019 | +0.000 / -3.019 | +0.000 / -0.553 |
| static/07 | +0.40, -0.20, +0.80 | +0.000 / -3.969 | +0.000 / -2.756 | +0.000 / -0.339 |
| static/08 | +0.80, -1.20, -0.60 | +0.000 / -4.764 | +0.000 / -2.529 | +0.000 / -0.258 |
| static/09 | +0.80, -1.20, +0.80 | +0.000 / -5.034 | +0.000 / -2.799 | +0.000 / -0.528 |
| static/10 | +0.80, -0.60, +0.00 | +0.000 / -5.203 | +0.000 / -2.968 | +0.000 / -0.551 |
| static/11 | +0.80, +0.00, -0.60 | +0.000 / -4.504 | +0.000 / -2.270 | +0.000 / -0.551 |

측정 토크가 모두 0 → 토크를 계산하지 않는 하드웨어(mock). 토크 비교는 생략
