lch-98/arm6_sim2real/arm_bringup/config/reference_trajectories.yaml

# 기준 궤적 세트 (docs/00_roadmap.md 0단계)
#
# 이 파일은 고정한다. 시뮬레이션(mock, Gazebo)과 실물의 모든 단계에서 같은 파일을 돌려 결과를 비교한다.
# 바꾸면 이전 기록과 비교할 수 없으므로, 바꿀 때는 version을 올리고 기록을 새로 만든다.
#
# 단위: rad, m, s. 관절 순서는 joint1 ~ joint6
# 모든 자세와 자세 사이 직선 경로는 관절 한계(여유 0.05 rad), 자기간섭, 바닥 높이(3 cm 이상)를 검사한 값이다.

version: 2                  # 2026-11-11: 손목 길이(L5 70→95 mm) 변경으로 정지 자세 07 수정. 이전(version 1) 기록과 비교하지 않는다
joints: [joint1, joint2, joint3, joint4, joint5, joint6]
sample_rate_hz: 50          # 궤적 점 간격 (컨트롤러는 그 사이를 보간)

home_pose:  [0.000, 0.000, 0.000, 0.000, 0.000, 0.000]   # 상완 수직, 전완 수평
ready_pose: [0.000, 0.200, -0.300, 0.000, 0.800, 0.000]  # 스윕·정지자세의 출발점. TCP ≈ (0.39, 0, 0.21) m
move_time: 3.0              # 자세 사이 이동 시간 (5차 다항식, 정지-정지)

gripper:
  open: 0.018               # 핑거 한쪽 이동량 [m] (최대 0.020)
  close: 0.0
  move_time: 1.0

# (a) 관절별 사인 스윕: ready_pose를 중심으로 한 관절만 흔든다
#     q(t) = q_ready + A·w(t)·sin(2πt/T),  w(t): 처음·마지막 반주기 동안 0→1→0 으로 부드럽게
#     최고 속도 2πA/T 는 각 모터 정격 속도의 25% 이하 (joint1 4340P 22%, 나머지 15% 이하)
sweeps:
  - {joint: joint1, amplitude: 0.8, period: 6.0, cycles: 2}   # 최고 속도 0.84 rad/s
  - {joint: joint2, amplitude: 0.35, period: 5.0, cycles: 2}   # 최고 속도 0.44 rad/s
  - {joint: joint3, amplitude: 0.45, period: 5.0, cycles: 2}   # 최고 속도 0.57 rad/s
  - {joint: joint4, amplitude: 1.0, period: 4.0, cycles: 2}   # 최고 속도 1.57 rad/s
  - {joint: joint5, amplitude: 0.6, period: 4.0, cycles: 2}   # 최고 속도 0.94 rad/s
  - {joint: joint6, amplitude: 1.2, period: 4.0, cycles: 2}   # 최고 속도 1.88 rad/s

# (b) 정지 자세: 각 자세에서 hold_time 동안 멈춰 관절 토크(effort)를 기록 → 중력 토크 비교·질량 식별용
#     ready_pose → 자세 → ready_pose 순서로 오간다
static_poses:
  hold_time: 3.0
  average_last: 1.5         # 분석 때 hold 마지막 몇 초를 평균할지
  poses:
    - [0.000, -0.500, -1.200, 0.000, -0.600, 0.000]
    - [0.000, -0.500, -1.200, 0.000, 0.800, 0.000]
    - [0.000, -0.500, -0.600, 0.000, 0.000, 0.000]
    - [0.000, -0.500, 0.500, 0.000, -0.600, 0.000]
    - [0.000, -0.500, 0.500, 0.000, 0.800, 0.000]
    - [0.000, 0.000, -1.200, 0.000, 0.000, 0.000]
    - [0.000, 0.000, 0.000, 0.000, 0.000, 0.000]
    - [0.000, 0.400, -0.200, 0.000, 0.800, 0.000]   # version 2: J3 0 → -0.2 (손목이 길어져 바닥 여유가 3 cm 미만이 됨)
    - [0.000, 0.800, -1.200, 0.000, -0.600, 0.000]
    - [0.000, 0.800, -1.200, 0.000, 0.800, 0.000]
    - [0.000, 0.800, -0.600, 0.000, 0.000, 0.000]
    - [0.000, 0.800, 0.000, 0.000, -0.600, 0.000]

# (c) 픽앤플레이스: A 지점(y=+0.12)에서 집어 B 지점(y=-0.12)에 놓기. 그리퍼는 아래를 향함
#     (2026-11-10 베이스 +8 mm, 2026-11-11 손목 +25 mm 반영. 관절값은 그대로 두고 tcp 값만 갱신 — 그리퍼가 아래를 향해 tcp가 25 mm 내려감)
#     관절값은 아래 tcp 목표에 대해 역기구학으로 미리 계산한 값 (오차 < 0.1 mm, 그리퍼 기울기 < 0.5°)
pick_place:
  waypoints:
    - {name: ready   , q: ready_pose, gripper: open}
    - {name: above_A , q: [0.380, 0.738, -0.992, 0.000, 1.821, 0.000], gripper: open}   # tcp [0.3, 0.12, 0.133]
    - {name: at_A    , q: [0.381, 0.706, -0.569, 0.000, 1.435, 0.000], gripper: open}   # tcp [0.3, 0.12, 0.053]
    - {name: grasp   , q: [0.381, 0.706, -0.569, 0.000, 1.435, 0.000], gripper: close}   # tcp [0.3, 0.12, 0.053]
    - {name: lift_A  , q: [0.380, 0.738, -0.992, 0.000, 1.821, 0.000], gripper: close}   # tcp [0.3, 0.12, 0.133]
    - {name: above_B , q: [-0.380, 0.742, -0.999, 0.000, 1.826, 0.000], gripper: close}   # tcp [0.3, -0.12, 0.133]
    - {name: at_B    , q: [-0.381, 0.706, -0.569, 0.000, 1.435, 0.000], gripper: close}   # tcp [0.3, -0.12, 0.053]
    - {name: release , q: [-0.381, 0.706, -0.569, 0.000, 1.435, 0.000], gripper: open}   # tcp [0.3, -0.12, 0.053]
    - {name: lift_B  , q: [-0.380, 0.742, -0.999, 0.000, 1.826, 0.000], gripper: open}   # tcp [0.3, -0.12, 0.133]
    - {name: back    , q: ready_pose, gripper: close}
