lch-98/arm6_sim2real/arm_bringup/config/controllers_j1to3.yaml

# ros2_control 컨트롤러 설정 — J1~J3 서브 어셈블리 (stage:=j1to3, docs/00_roadmap.md 3단계)
controller_manager:
  ros__parameters:
    update_rate: 200

    joint_state_broadcaster:
      type: joint_state_broadcaster/JointStateBroadcaster
    arm_controller:
      type: joint_trajectory_controller/JointTrajectoryController

arm_controller:
  ros__parameters:
    joints: [joint1, joint2, joint3]
    command_interfaces: [position]
    state_interfaces: [position, velocity]
    state_publish_rate: 100.0
    action_monitor_rate: 20.0
    allow_partial_joints_goal: false
    constraints:
      stopped_velocity_tolerance: 0.05
      goal_time: 2.0
      joint1: {trajectory: 0.3, goal: 0.03}
      joint2: {trajectory: 0.3, goal: 0.03}
      joint3: {trajectory: 0.3, goal: 0.03}
