lch-98/arm6_sim2real/(commit log)

2026-11-04 Stage 0: simulation baseline (ros2_control mock/Gazebo, reference trajectories, analysis)
    [arm.ros2_control.xacro, arm.urdf.xacro, arm_assembly.step, arm_macro.xacro, arm_properties.xacro, base_link.step, base_link.stl, base_link__base_band.step]
2026-11-11 키트 모터 구성 반영, 손목·그리퍼 간섭 수정, 그리퍼 랙 안내 구조, 분해도 STEP
    [arm.ros2_control.xacro, arm_assembly.step, arm_exploded.step, arm_macro.xacro, arm_properties.xacro, base_link.step, base_link.stl, base_link__base_band.step]
2026-11-11 0단계 기준선 재기록 (키트 모터 구성, 기준 궤적 version 2)
2026-11-11 0단계 기준선 재기록 (키트 모터 구성, 기준 궤적 version 2)-04_sim_baseline.md 미반영으로 인한 re commit
2026-11-12 1단계 벤치 도구(arm_hardware): Damiao CAN 프로토콜, 가상 모터, dm_bench
    [motors.yaml]
2026-11-12 1단계 ros2_control 하드웨어 인터페이스(DamiaoSystem), real.launch.py, hold 양방향 측정
    [arm.ros2_control.xacro, arm.urdf.xacro, controllers_real_overrides.yaml, motors.yaml]
